raulhorgos/Automotive-electronics-system-project/Driver.png

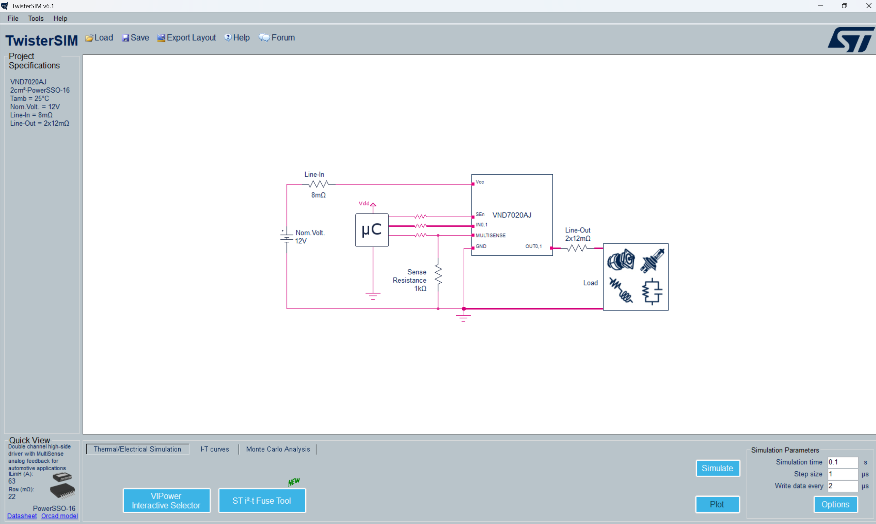
Driver.png
