raulhorgos/Automotive-electronics-system-project/LTSpice simulations/fast_transient.png

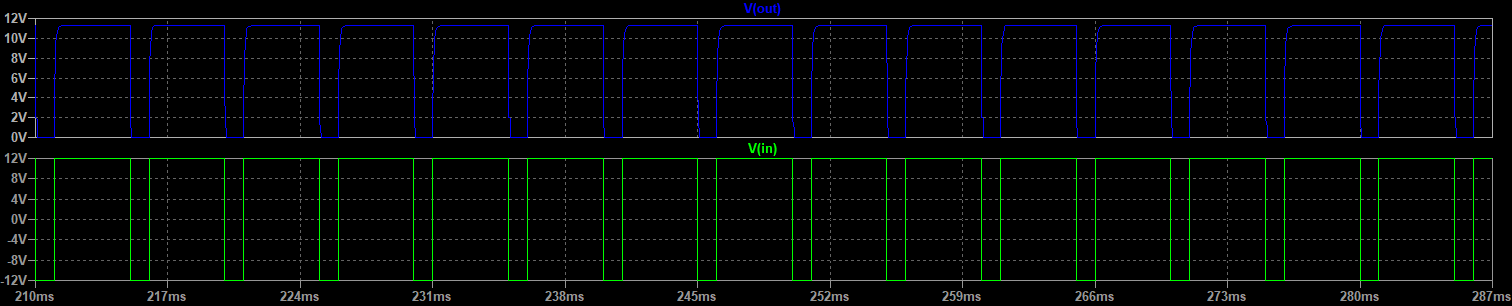
LTSpice simulations/fast_transient.png
