raulhorgos/Automotive-electronics-system-project/LTSpice simulations/Protection circuit.PNG

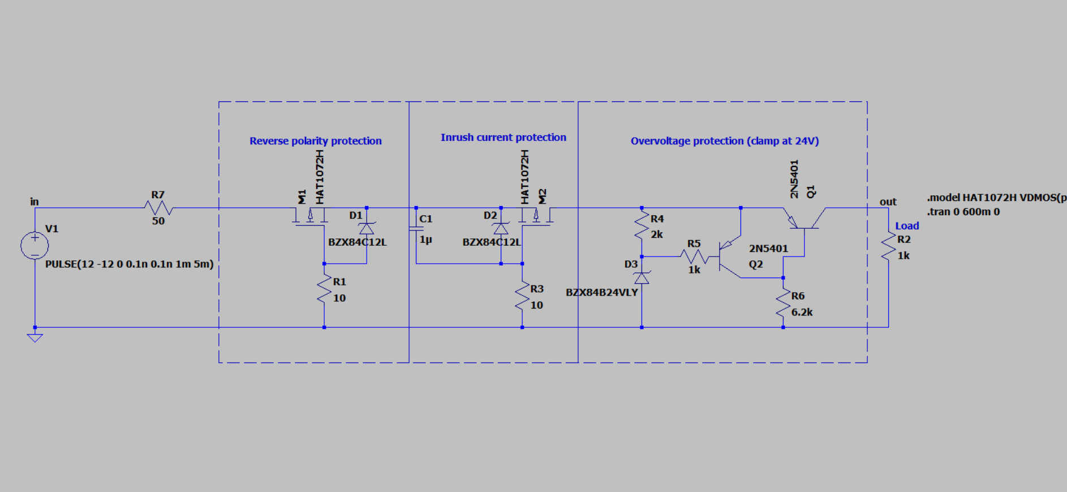
LTSpice simulations/Protection circuit.PNG
