raulhorgos/Automotive-electronics-system-project/Altium Files/Project Outputs for PCB_Project/BOM.PDF

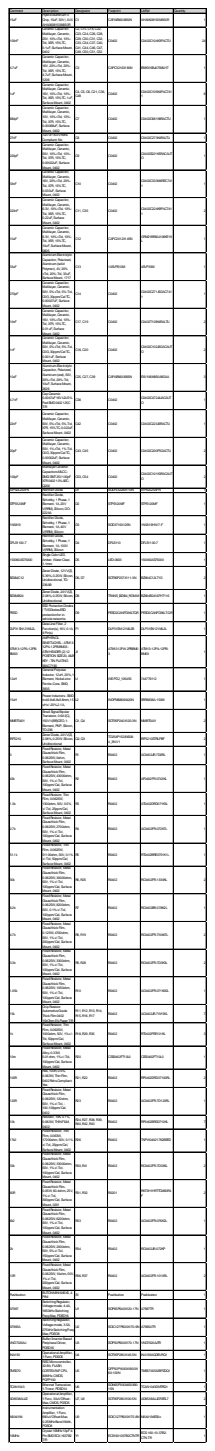
[picture p4: page 1]

100nF | Ceramic Capacitor, Multilayer, Ceramic, 25V, 10%+Tol, 10%-Tol, X5R, 15%TC, 0.1uF, SurfaceMount, 0402 | C2, C15, C16, C22, C23, C24, C26, C28, C29, C30, C31, C32, C33, C34, C37, C40, C41, C44, C46, C47, C49, C50, C51, C52 | C0402 | C0402C104K3PACTU | 24

4.7uF | Ceramic Capacitor, Multilayer, Ceramic, 16V, 20%+Tol, 20%-Tol, X5R, 15%TC, 4.7uF, SurfaceMount, 1206 | C3 | CAPC3216X180N | EMK316BJ475MLHT | 1

1uF | Ceramic Capacitor, Multilayer, Ceramic, 16V, 10%+Tol, 10%-Tol, X5R, 15%TC, 1uF, SurfaceMount, 0402 | C4, C5, C6, C21, C36, C48 | C0402 | C0402C105K4PAC741 1 | 6

680pF | Ceramic Capacitor, Multilayer, Ceramic, 10V, 10%+Tol, 10%-Tol, X7R, 15%TC, 0.00068uF, Surface Mount, 0402 | C7 | C0402 | C0402C681K8RACTU | 1

27nF | .027Uf 16.0VRohs Compliant: No | C8 | C0402 | C0402C273K4RALTU | 1

220pF | Ceramic Capacitor, Multilayer, Ceramic, 50V, 10%+Tol, 10%-Tol, X7R, 15%TC, 0.00022uF, Surface Mount, 0402 | C9 | C0402 | C0402S221K5RACAUT O | 1

33nF | Ceramic Capacitor, Multilayer, Ceramic, 16V, 20%+Tol, 20%-Tol, X7R, 15%TC, 0.033uF, Surface Mount, 0402 | C10 | C0402 | C0402C333M4REC741 1 | 1

220nF | Ceramic Capacitor, Multilayer, Ceramic, 6.3V, 10%+Tol, 10%-Tol, X5R, 15%TC, 0.22uF, Surface Mount, 0402 | C11, C35 | C0402 | C0402C224K9PAC741 1 | 2

10uF | Ceramic Capacitor, Multilayer, Ceramic, 6.3V, 10%+Tol, 10%-Tol, X5R, 15%TC, 10uF, SurfaceMount, 0805 | C12 | CAPC2012X145N | GRM21BR60J106KE19 L | 1

33uF | AluminumElectrolytic Capacitor, Polarized, Aluminum(solid Polymer), 4V, 20% +Tol, 20%-Tol, 33uF, SurfaceMount, 1717 | C13 | 10SVPS10M | 4SVP33M | 1

270pF | Ceramic Capacitor, Multilayer, Ceramic, 50V, 5%+Tol, 5%-Tol, C0G, 30ppm/Cel TC, 0.00027uF, Surface Mount, 0402 | C14 | C0402 | C0402C271J5GAC741 1 | 1

10nF | Ceramic Capacitor, Multilayer, Ceramic, 16V, 10%+Tol, 10%-Tol, X7R, 15%TC, 0.01uF, Surface Mount, 0402 | C17, C19 | C0402 | C0402T103K4RALTU | 2

1nF | Ceramic Capacitor, Multilayer, Ceramic, 50V, 5%+Tol, 5%-Tol, C0G, 30ppm/Cel TC, 0.001uF, Surface Mount, 0402 | C18, C20 | C0402 | C0402C102J5GACAUT O | 2

10uF | AluminumElectrolytic Capacitor, Polarized, Aluminum(wet), 50V, 20%+Tol, 20%-Tol, 10uF, SurfaceMount, 2626 | C25, C27, C39 | CAPAE660X565N | EXV106M050A9GAA | 3

4.7nF | CapCeramic 0.0047uF16VU2J5% PadSMD0402125C T/R | C38 | C0402 | C0402C472J4JACAUT O | 1

22nF | Ceramic Capacitor, Multilayer, Ceramic, 50V, 5%+Tol, 5%-Tol, X7R, 15%TC, 0.022uF, SurfaceMount, 0402 | C42 | C0402 | C0402C223J5RACTU | 1

20pF | Ceramic Capacitor, Multilayer, Ceramic, 50V, 1%+Tol, 1%-Tol, C0G, 30ppm/Cel TC, 0.00002uF, Surface Mount, 0402 | C43, C45 | C0402 | C0402C200F5GACTU | 2

100pF | Multilayer Ceramic Capacitors MLCC-SMD/SMT25V100pF X7R040210%AEC-Q200 | C53, C54 | C0402 | C0402C101K3RACAUT O | 2

STPS2L25AFN STPS120MF | Rectifier Diode, Rectifier Diode Schottky, 1Phase, 1 Element, 1A, 20V V(RRM), Silicon, DO-222AA | D1 D2 | SODFL5226X110N STPS120MF | STPS2L25AFN STPS120MF | 1 1

1N5819 | Rectifier Diode, Schottky, 1Phase, 1 Element, 1A, 40V V(RRM), Silicon | D3 | SOD3716X125N | 1N5819HW-7-F | 1

DFLS1100-7 | Rectifier Diode, Schottky, 1Phase, 1 Element, 1A, 100V V(RRM), Silicon | D4 | DFLS110 | DFLS1100-7 | 1

150060AS75000 | SingleColor LED, Amber, Water Clear, 1.1mm | D5 | LED-0603 | 150060AS75000 | 1

BZX84C12 | Zener Diode, 12VV(Z), 5.39%, 0.25W, Silicon, Unidirectional, TO-236AB | D6, D7 | SOT96P237X111-3N | BZX84C12LT1G | 2

BZX84B24 | Zener Diode, 24VV(Z), 2.08%, 0.25W, Silicon, Unidirectional | D8 | TRANS_BZX84_ROM-M | BZX84B24VLFHT116 | 1

PESD | / TVSDiodesESD ESDProtectionDiodes protectionfor in-vehicle networks | D9 | PESD2CANFD36LTQR | PESD2CANFD36LT-QR | 1

DLP31SN121ML2L | DataLineFilter, 2 Function(s), 16V, 0.1A, 4Pin(s) | F1 | DLP31SN121ML2B | DLP31SN121ML2L | 1

ATM13-12PA-12PB-BM03 | AMPHENOL SINE/TUCHEL- ATM13-12PA-12PB-BM03-ATMHEADER (2)12 POSITIONSIZE20, A&B KEY- TINPLATING 98AC7190 | J1 | ATM1312PA12PBBM0 3 | ATM13-12PA-12PB-BM03 | 1

12uH | General Purpose Inductor, 12uH, 20%, 1 Element, Nickel-zinc Ferrite-Core, SMD, 3935 | L1 | WE-PD2_105455 | 744776112 | 1

15uH | Power Inductors - SMD Ind,6.8x6.8x3.8mm,15 uH+/-20%,2.1A, | L2 | INDPM6868X420N | SRR6838A-150M | 1

MMBT5401 | Small Signal Bipolar Transistor, 0.6AI(C), 150VV(BR)CEO, 1-Element, PNP, Silicon, TO-236 | Q1, Q4 | SOT95P240X120-3N | MMBT5401 | 2

IRF5210 | Zener Diode, 24VV(Z), 2.08%, 0.25W, Silicon, Unidirectional | Q2, Q3 | TO254P1528X508-4_3N-V1 | IRF5210STRLPBF | 2

0 | FixedResistor, Metal Glaze/thickFilm, 0.0625W, 0ohm, SurfaceMount, 0402 | R1 | R0402 | AC0402JR-7D0RL | 1

43k | FixedResistor, Metal Glaze/thickFilm, 0.0625W, 43000ohm, 50V, 1%+/-Tol, 100ppm/Cel, Surface Mount, 0402 | R2 | R0402 | AF0402FR-0743KL | 1

1.3k | FixedResistor, Thin Film, 0.0625W, 1300ohm, 50V, 0.5% +/-Tol, 25ppm/Cel, SurfaceMount, 0402 | R3 | R0402 | AT0402DRD071K3L | 1

2.7k | FixedResistor, Metal Glaze/thickFilm, 0.0625W, 2700ohm, 50V, 1%+/-Tol, 100ppm/Cel, Surface Mount, 0402 | R4 | R0402 | AC0402FR-072K7L | 1

51.1k | FixedResistor, Thin Film, 0.0625W, 51100ohm, 50V, 0.1% +/-Tol, 50ppm/Cel, SurfaceMount, 0402 | R5 | R0402 | RT0402BRE0751K1L | 1

30k | FixedResistor, Metal Glaze/thickFilm, 0.0625W, 30000ohm, 50V, 1%+/-Tol, 100ppm/Cel, Surface Mount, 0402 | R6, R25 | R0402 | RC0402FR-1330KL | 2

8.2k | FixedResistor, Metal Glaze/thickFilm, 0.0625W, 8200ohm, 50V, 0.1%+/-Tol, 100ppm/Cel, Surface Mount, 0402 | R7 | R0402 | RC0402BR-078K2L | 1

4.7k | FixedResistor, Metal Glaze/thickFilm, 0.125W, 4700ohm, 50V, 1%+/-Tol, 200ppm/Cel, Surface Mount, 0402 | R8, R19 | R0402 | RC0402FR-7W4K7L | 2

3.3k | FixedResistor, Metal Glaze/thickFilm, 0.0625W, 3300ohm, 50V, 1%+/-Tol, 100ppm/Cel, Surface Mount, 0402 | R9, R28 | R0402 | RC0402FR-7D3K3L | 2

1.05k | FixedResistor, Metal Glaze/thickFilm, 0.0625W, 1050ohm, 50V, 1%+/-Tol, 100ppm/Cel, Surface Mount, 0402 | R10 | R0402 | AC0402FR-071K05L | 1

15k | ChipResistor AutomotiveGrade ThickFilm 0402 15kOhm5%Paper T/R | R11, R12, R13, R14, R15, R16, R17 | R0402 | AC0402JR-7W15KL | 7

1k | FixedResistor, Thin Film, 0.0625W, 1000ohm, 50V, 1%+/-Tol, 50ppm/Cel, SurfaceMount, 0402 | R18, R29, R35 | R0402 | RT0402FRE101KL | 3

10m | FixedResistor, Metal Alloy, 0.33W, 0.01ohm, 1%+/-Tol, 100ppm/Cel, Surface Mount, 0402 | R20 | CSS0402FT10L0 | CSS0402FT10L0 | 1

100R | Res, 100R, 0.5%, 0.063W, ThinFilm, 0402RohsCompliant: Yes | R21, R22 | R0402 | RP0402DRD07100RL | 2

120R | FixedResistor, Metal Glaze/thickFilm, 0.0625W, 120ohm, 50V, 1%+/-Tol, -100,100ppm/Cel, 0402 | R23 | R0402 | AC0402FR-7D120RL | 1

10k | Resistor, 10K, 0.1%, 0.063W, THINFILM, 0402; | R24, R27, R38, R39, R40, R42, R43 | R0402 | RP0402BRD0710KL | 7

17k2 | FixedResistor, Thin Film, 0.063W, 17200ohm, 50V, 0.1% +/-Tol, 25ppm/Cel, SurfaceMount, 0402 | R26 | R0402 | TNPW040217K2BEED | 1

33k | FixedResistor, Metal Glaze/thickFilm, 0.0625W, 33000ohm, 50V, 1%+/-Tol, 100ppm/Cel, Surface Mount, 0402 | R30, R41 | R0402 | RC0402FR-7D33KL | 2

60R | FixedResistor, Metal Glaze/thickFilm, 0.05W, 60.4ohm, 25V, 1%+/-Tol, 300ppm/Cel, Surface Mount, 0201 | R31, R32 | R0201 | RK73H1HRTTCM60R4 F | 2

6k2 | FixedResistor, Metal Glaze/thickFilm, 0.0625W, 6200ohm, 50V, 1%+/-Tol, 100ppm/Cel, Surface Mount, 0402 | R33 | R0402 | AC0402FR-076K2L | 1

2k | FixedResistor, Metal Glaze/thickFilm, 0.0625W, 2000ohm, 50V, 5%+/-Tol, 150ppm/Cel, Surface Mount, 0402 | R34 | R0402 | RC0402JR-072KP | 1

10R | FixedResistor, Metal Glaze/thickFilm, 0.0625W, 10ohm, 50V, 1%+/-Tol, 200ppm/Cel, Surface Mount, 0402 | R36, R37 | R0402 | AC0402FR-1010RL | 2

Pushbutton | BUTONMINI6X6X5, 4 PINI | S1 | Pushbutton | Pushbutton | 1

A7987 | SwitchingRegulator, Voltage-mode, 4.4A, 1650kHzSwitching Freq-Max, PDSO16 | U1 | SOP65P640X120-17N | A7987TR | 1

A7985A | SwitchingRegulator, Voltage-mode, 3.5A, 275kHzSwitchingFreq-Max, PDSO8 | U2 | SOIC127P600X170-9N | A7985ATR | 1

VND7020AJ | Buffer/Inverter Based Peripheral Driver, PDSO16 | U3 | SOP50P600X170-17N | VND7020AJTR | 1

INA193 | Operational Amplifier, 1Func, PDSO5 | U4 | SOT95P280X145-5N | INA193AQDBVRQ1 | 1

TMS570 | RISCMicrocontroller, 32-Bit, FLASH, CORTEX-R4FCPU, 80MHz, CMOS, PQFP100 | U5 | QFP50P1600X1600X1 60-100N | TMS5700332BPZQQ1 | 1

TCAN1043 | Ethernet Transceiver, 1-Trnsvr, PDSO14 | U6 | SON65P300X450X90-15N | TCAN1043DMTRQ1 | 1

AD8538AUJZ | Operational Amplifier, 1Func, 30uVOffset-Max, CMOS, PDSO5 | U7, U8 | SOT95P280X100-5N | AD8538AUJZ-REEL7 | 2

MAX4194 | Instrumentation Amplifier, 1Func, 690uVOffset-Max, 0.25MHzBandWidth, PDSO8 | U9 | SOIC127P600X175-8N | MAX4194ESA+ | 1

16MHz | Crystal 16MHz10pF4-PinSMDECX-1637B2 T/R | Y1 | ECS1601037B2CTNTR | ECS-160-10-37B2-CTN-TR | 1
