raulhorgos/Automotive-electronics-system-project/LTSpice simulations/Reverse polarity results.PNG

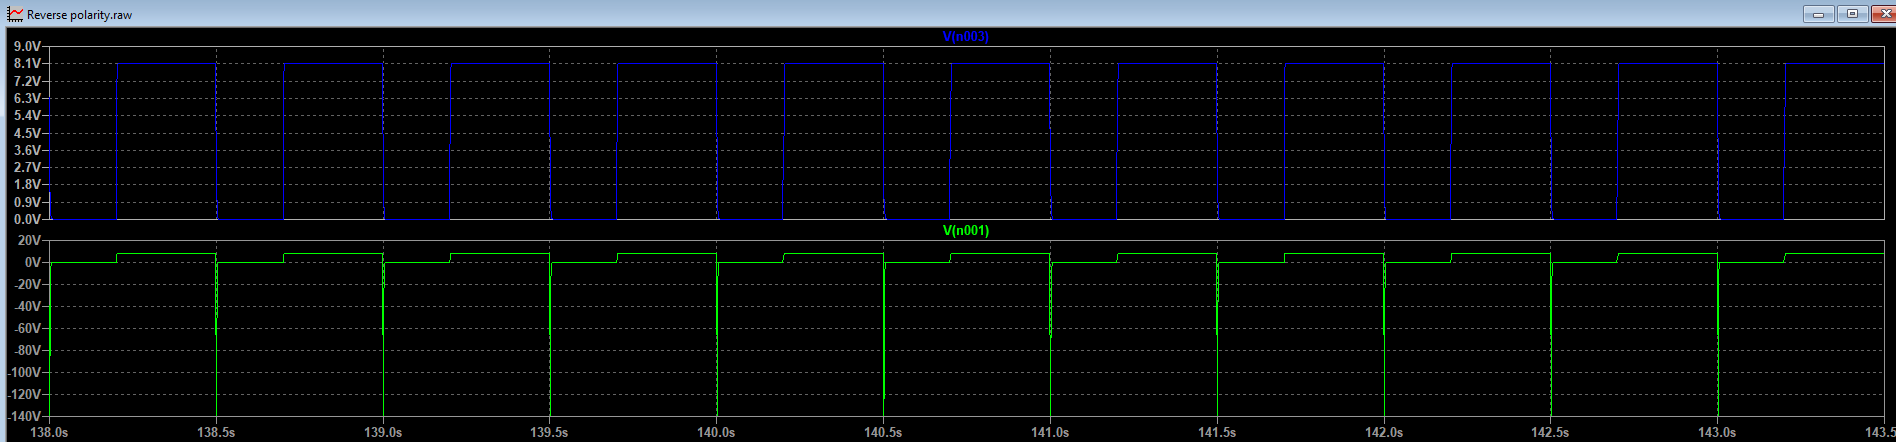
LTSpice simulations/Reverse polarity results.PNG
