raulhorgos/Automotive-electronics-system-project/Shunt measurement TinaTI.PDF

# Linearity_INA_LM

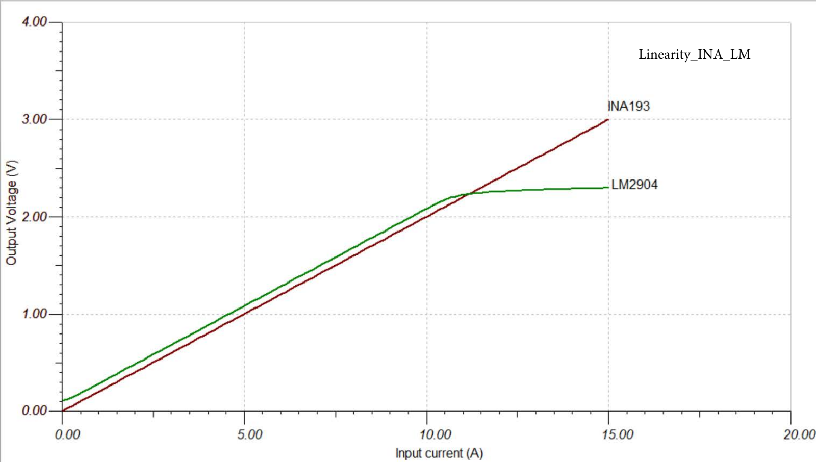
[picture p6: page 1]

# Shunt Tina TI

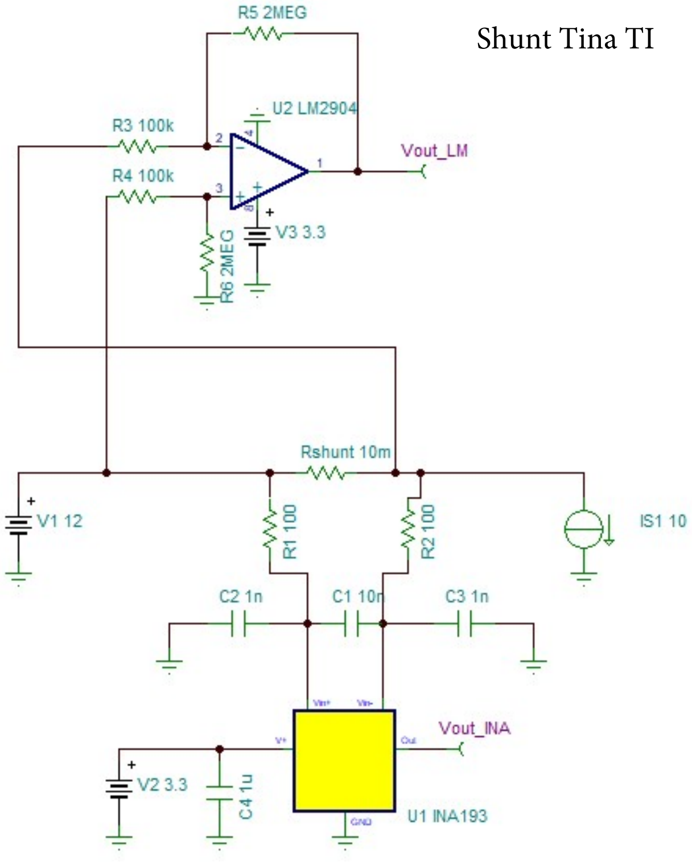
[picture p7: page 2]

# Temp_10A

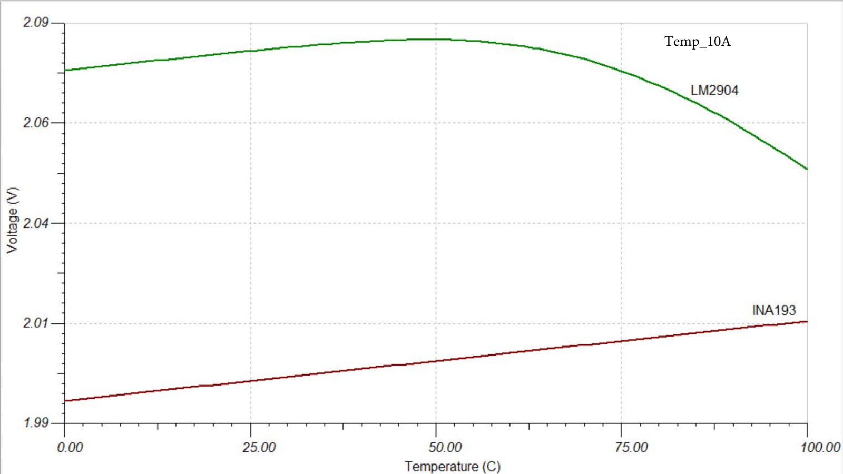
[picture p8: page 3]
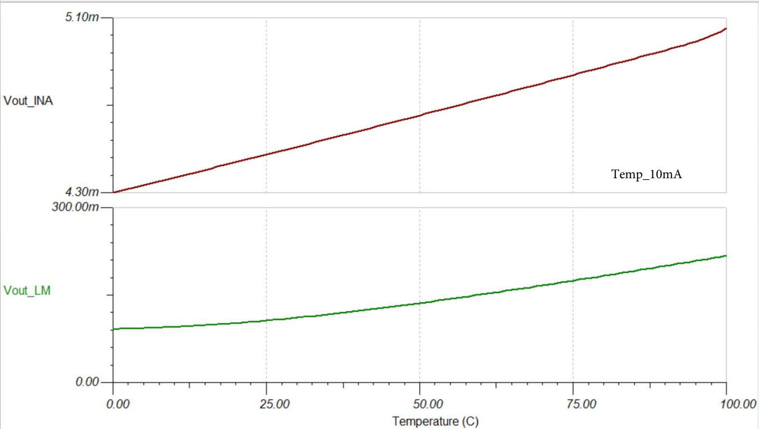
[picture p9: page 4]

# Temp_10mA

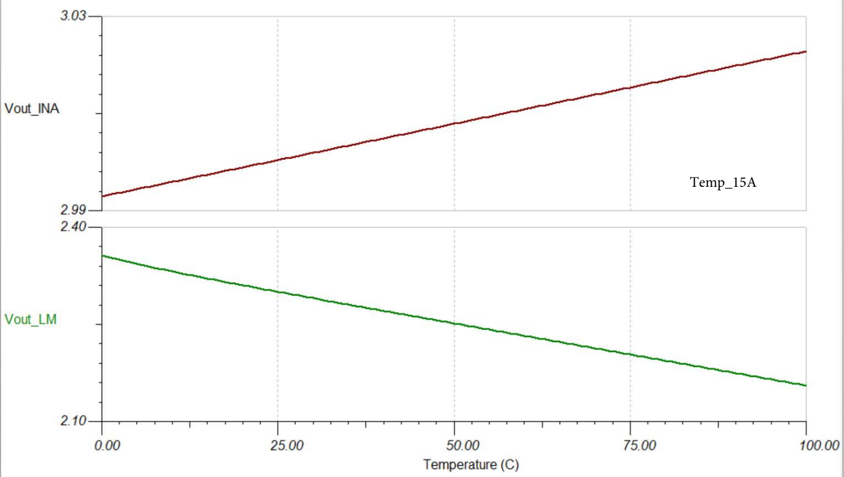
[picture p10: page 5]

# Temp_15A

# Tolerance_INA193

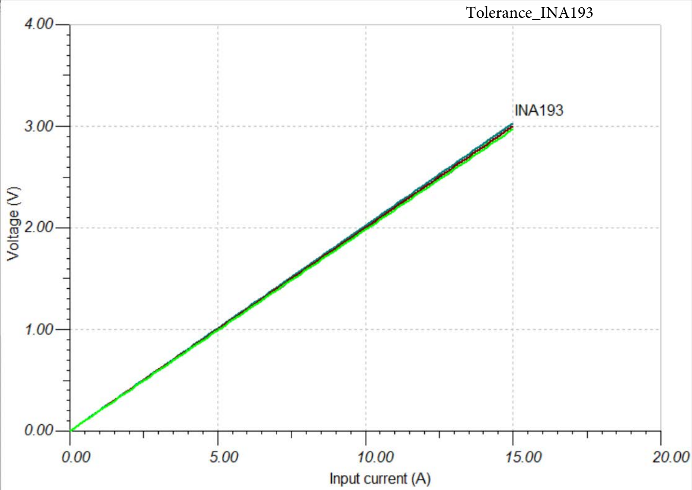
[picture p11: page 6]
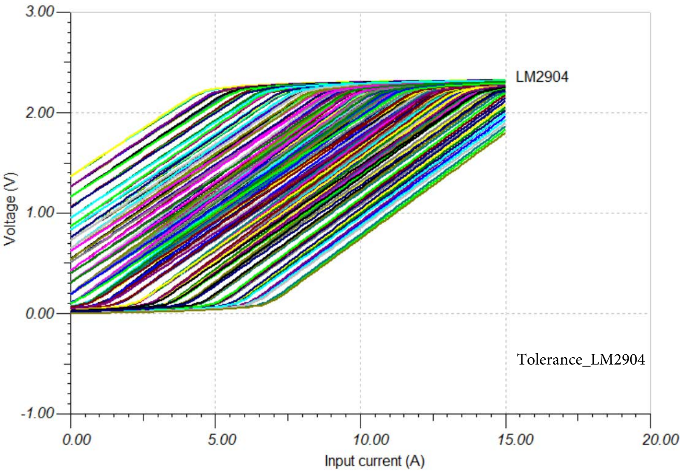
[picture p12: page 7]

# Tolerance_LM2904

1 | 1

# Drill Drawing View (Scale 1:1)

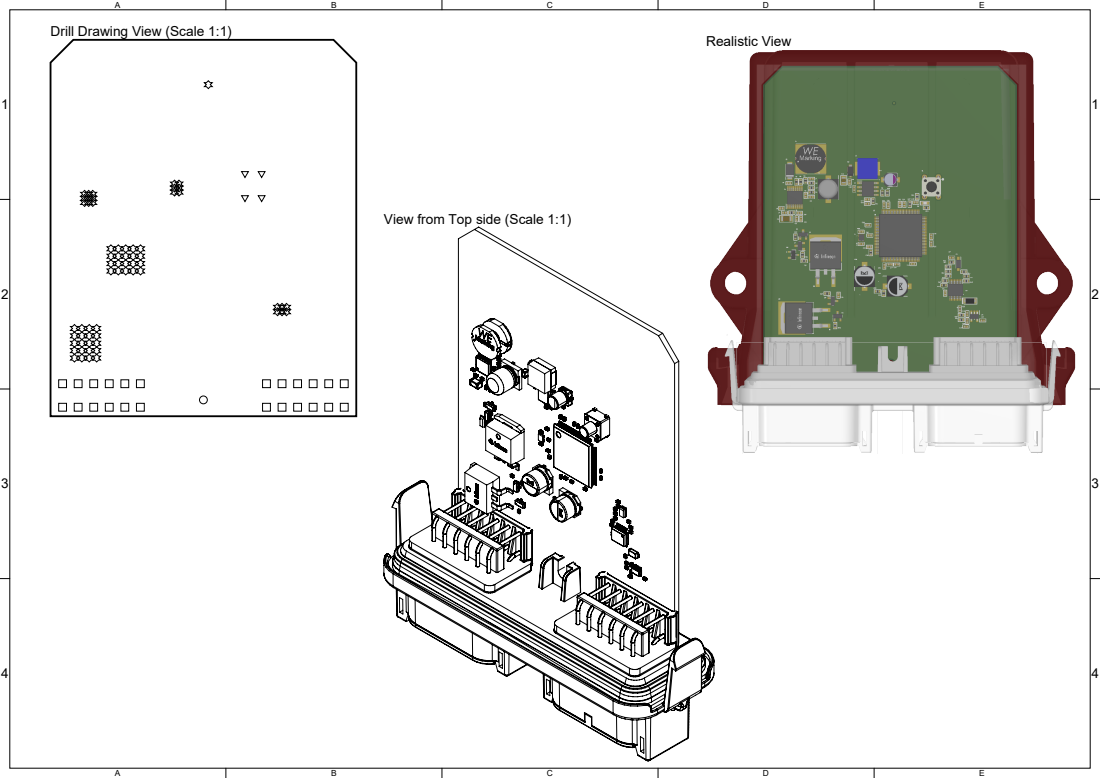
[picture p13: page 8]
Realistic View

View from Top side (Scale 1:1)

1 | 1

L1

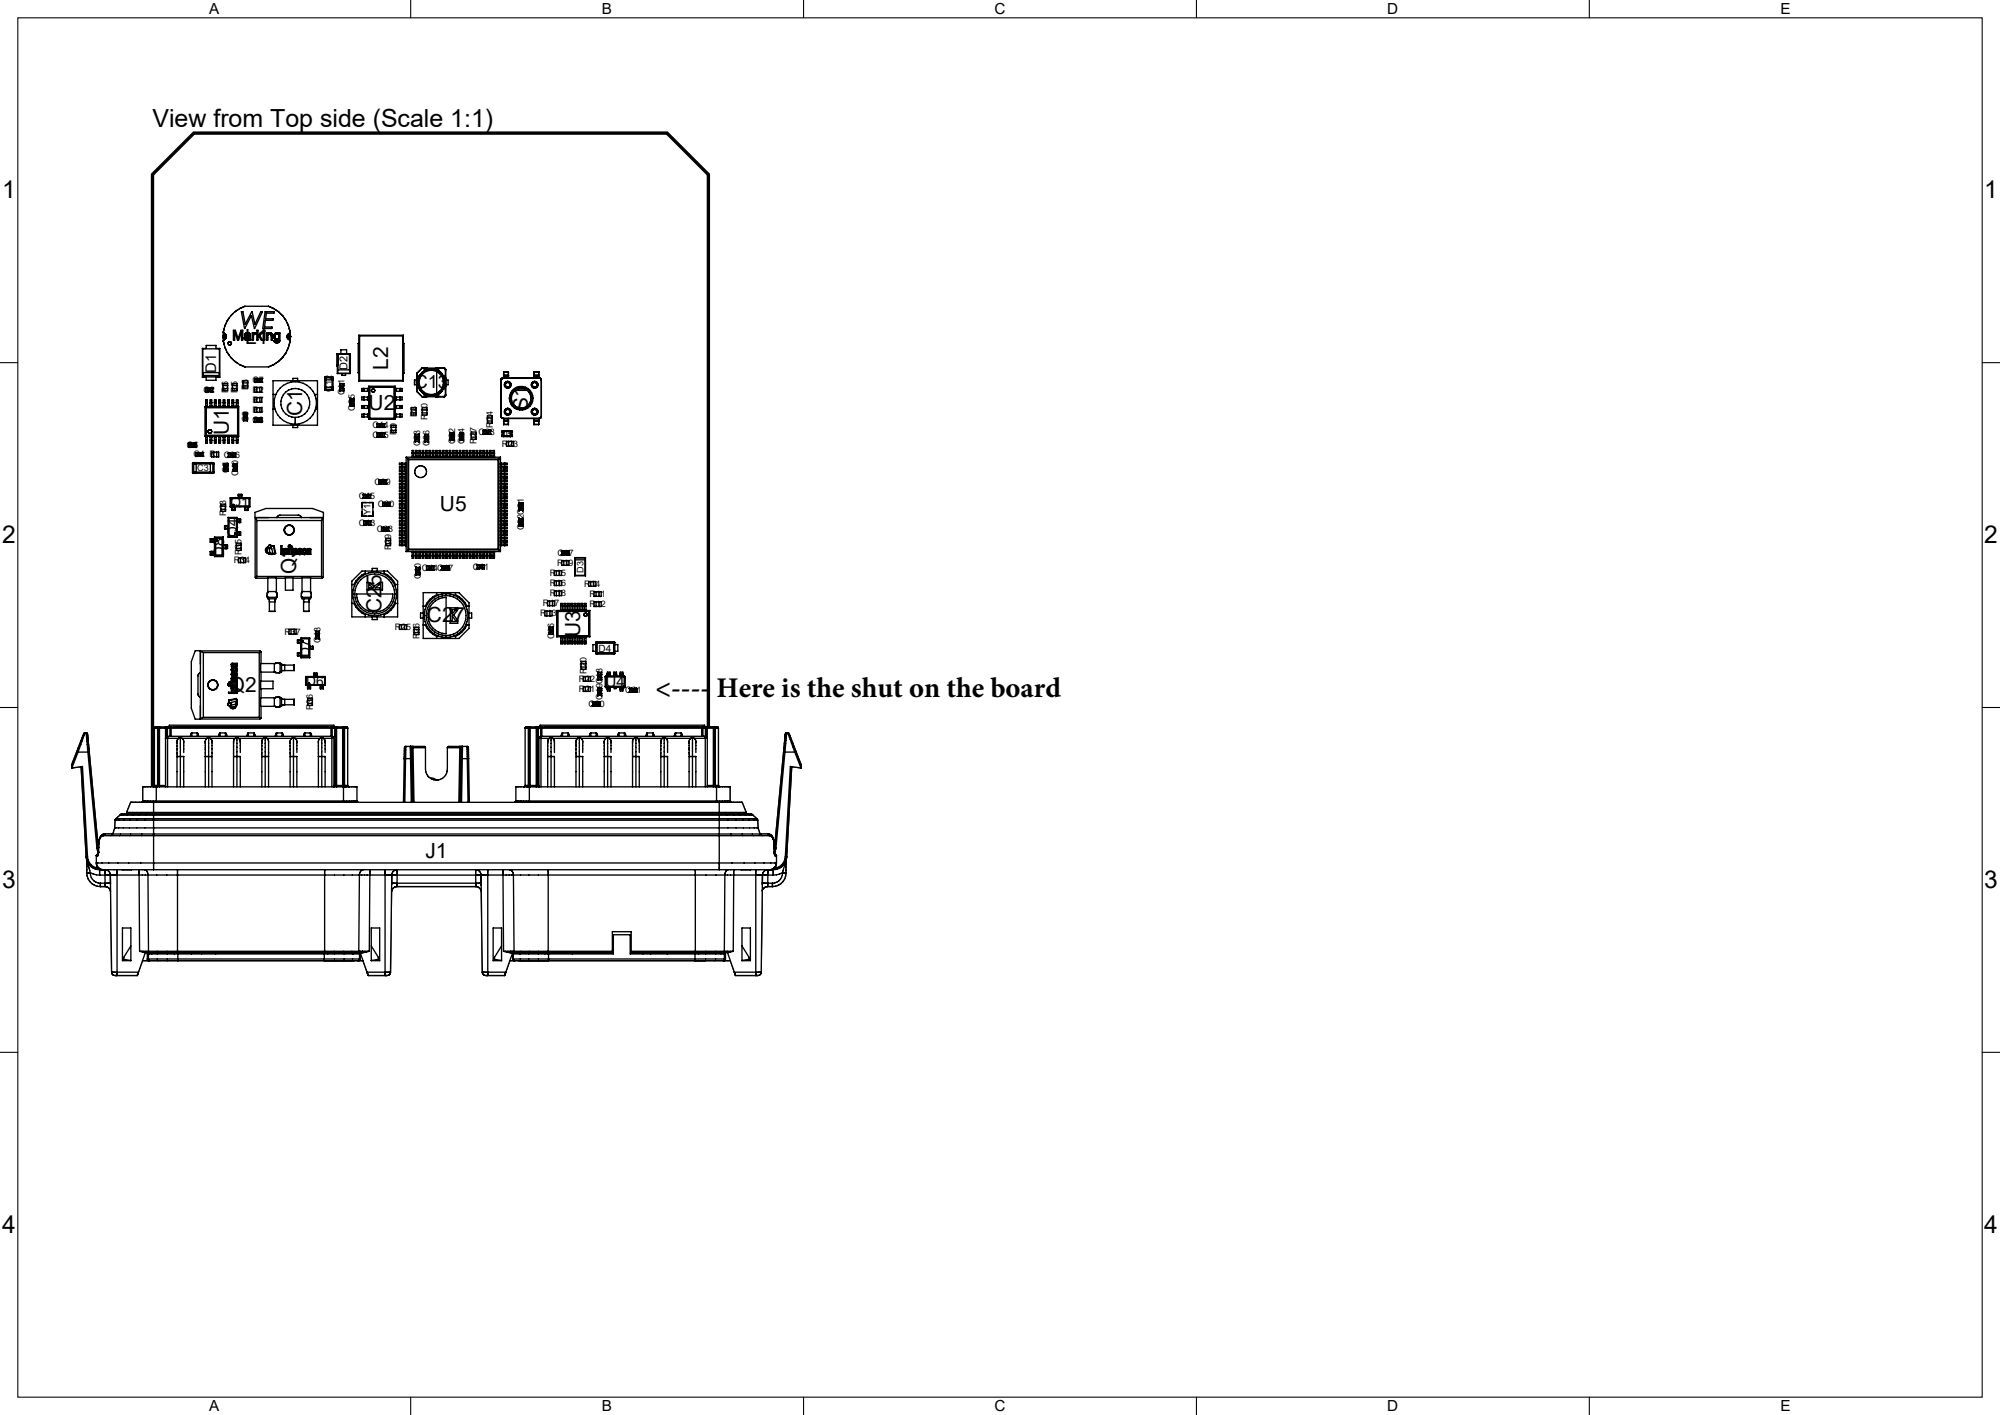
[picture p14: page 9]

View from Top side (Scale 1:1)

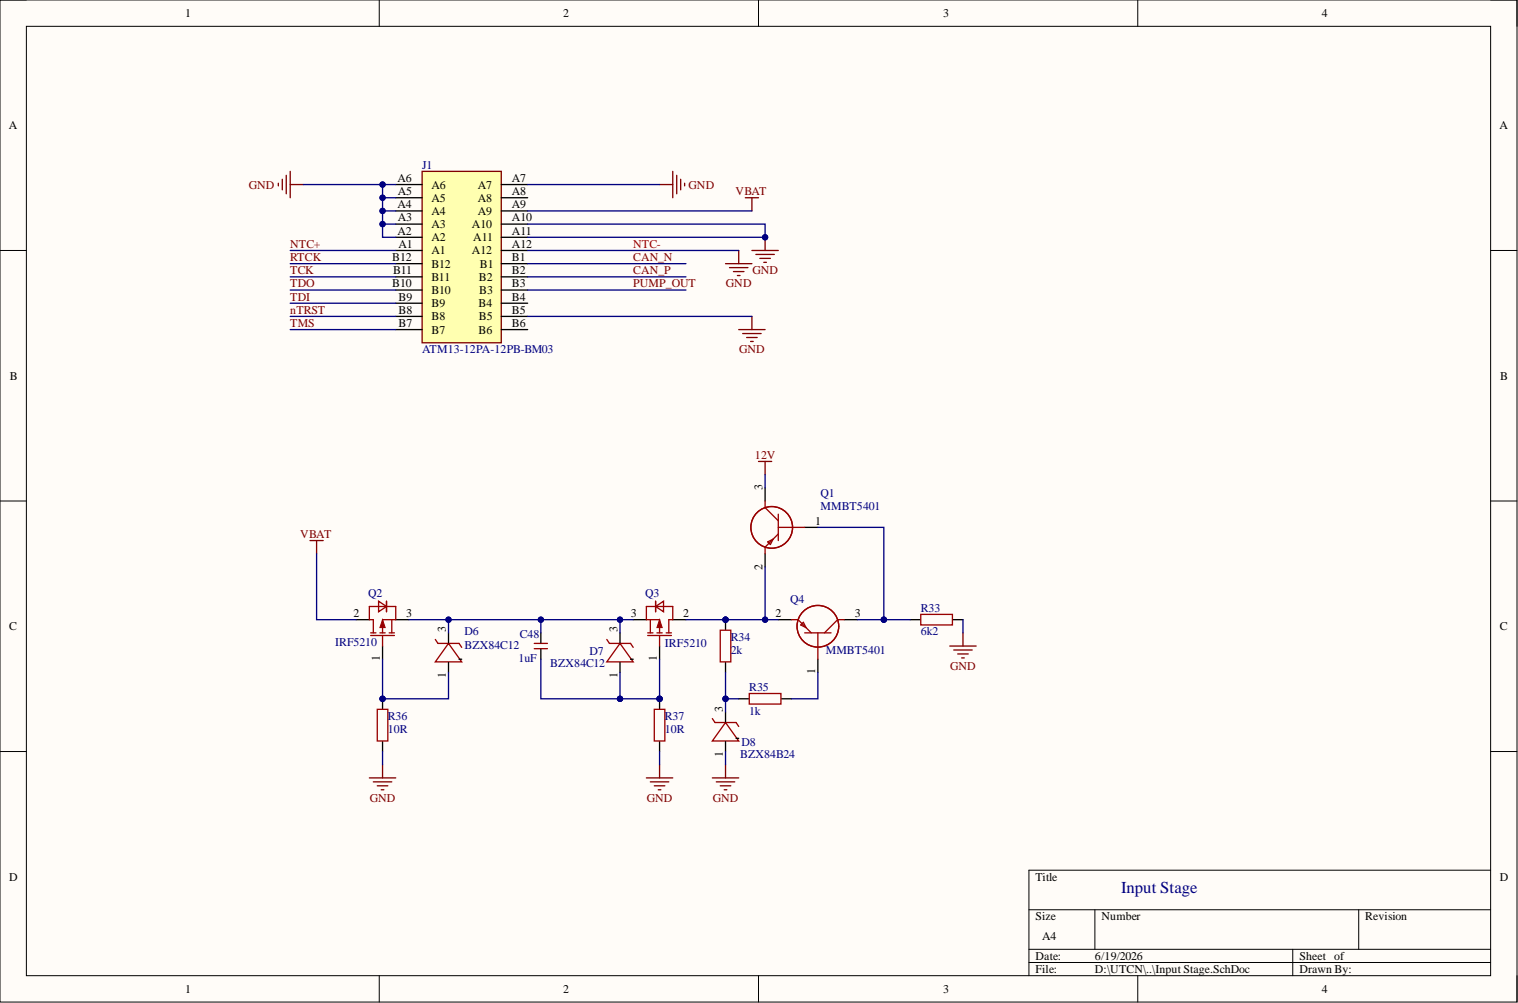
[picture p15: page 10]

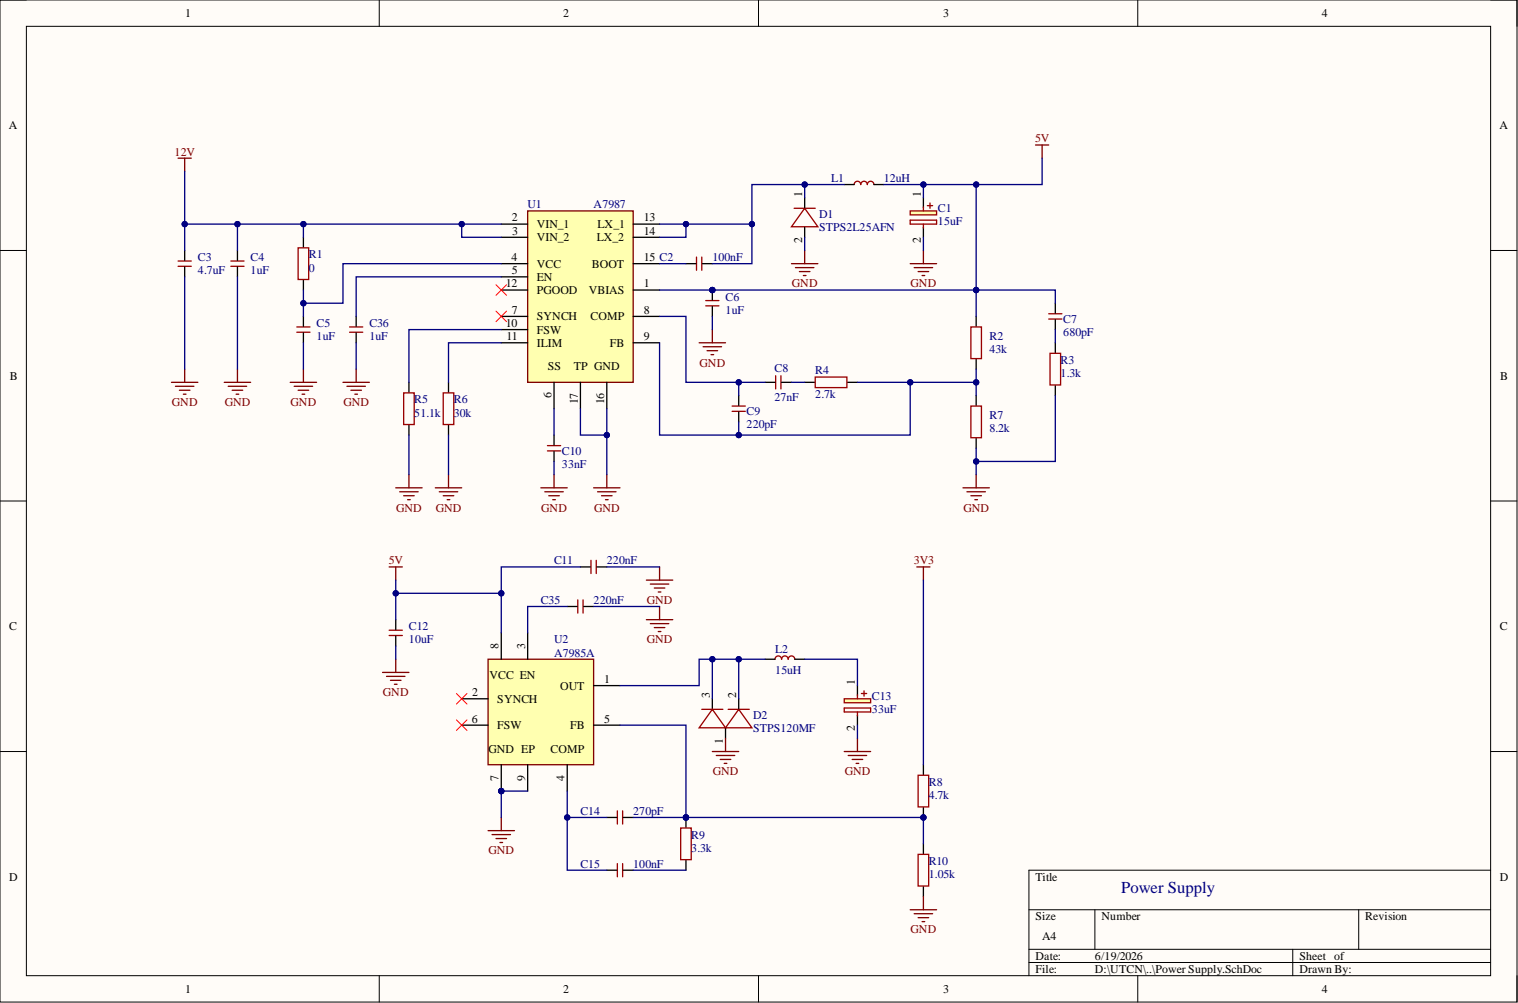
[picture p16: page 11]

## S1 GN

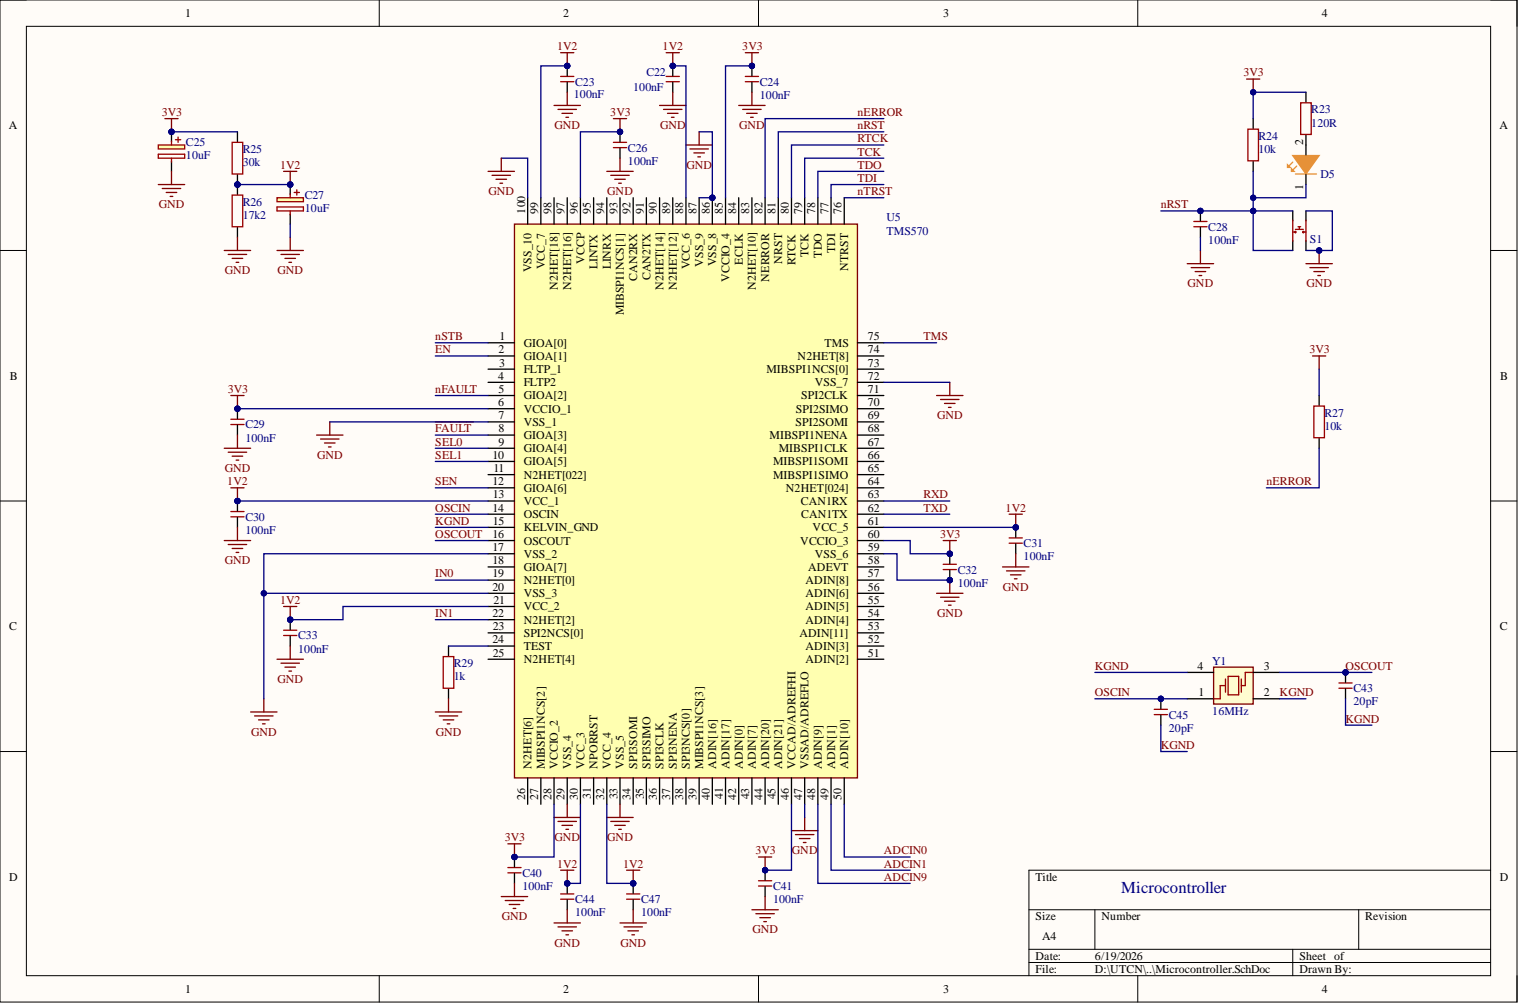
[picture p17: page 12]
Size; umb; Rev; Dat; Sheet; TCN; \..\Microco; tro; ler; Draw; GIO; FLTP_; FLT; VCCIO; VSS_; VCC_; OSCI; LVIN; OSCO; SPI2; NCS[0; N2HET[6] 26; MIBSPI1NCS[2] 27; VSS; VCC; NPORRST 31; SPI3SOMI 34 SPI3SIMO 35 SPI3CLK 36; SPI3NENA 37; SPI3NCS[0] 38; MIBSPI1NCS[3] 39; ADIN[16] 40; ADIN[17] 41 ADIN[0] 42; ADIN[7] 43; ADIN[20] 44; ADIN[21] 45; VCCAD/ADREFHI 46 VSSAD/ADREFLO 47; ADIN[9] 48; ADIN[1] 49; ADIN[10] 50; TMS; MIBSPI1; SPI2CL; SPI2SIM; SPI2SO; MIBSPI1CL; MIBSPI1SOMI; MIBSPI1SIMO; DIN; DIN[1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

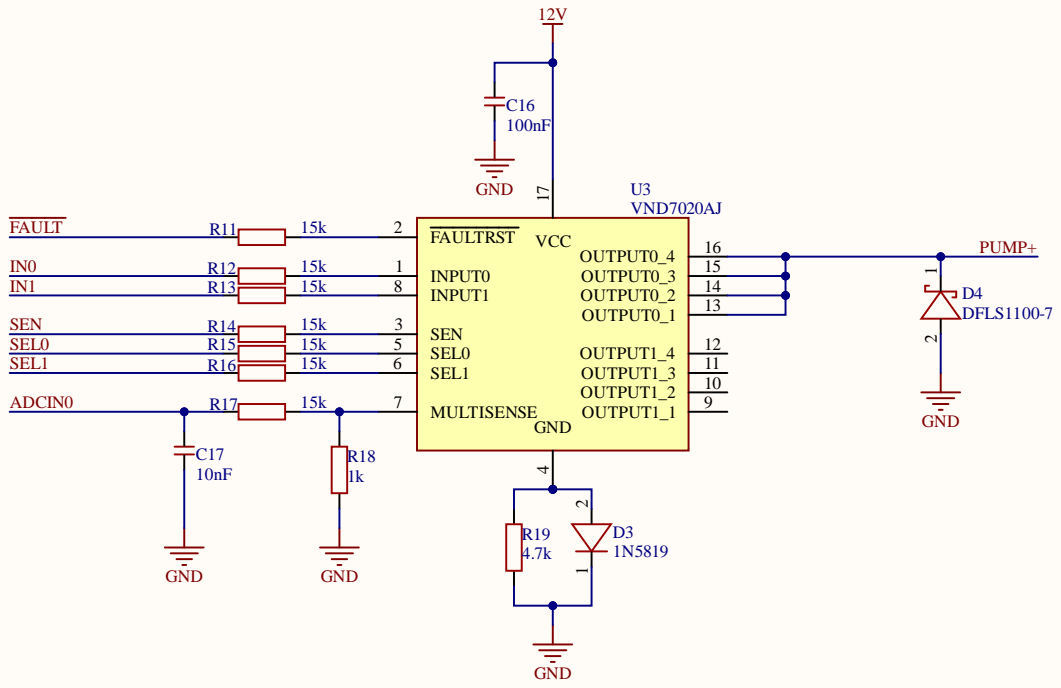
[picture p18: page 13]
Size; umb; Rev; Dat; Sheet; TCN; \..\Pump; Dri; ver.Sch; Draw; INPU; LTISE; VCC¹⁷; TPU; DCI; PUMP+; 4 DFLS1; Pump; Driver

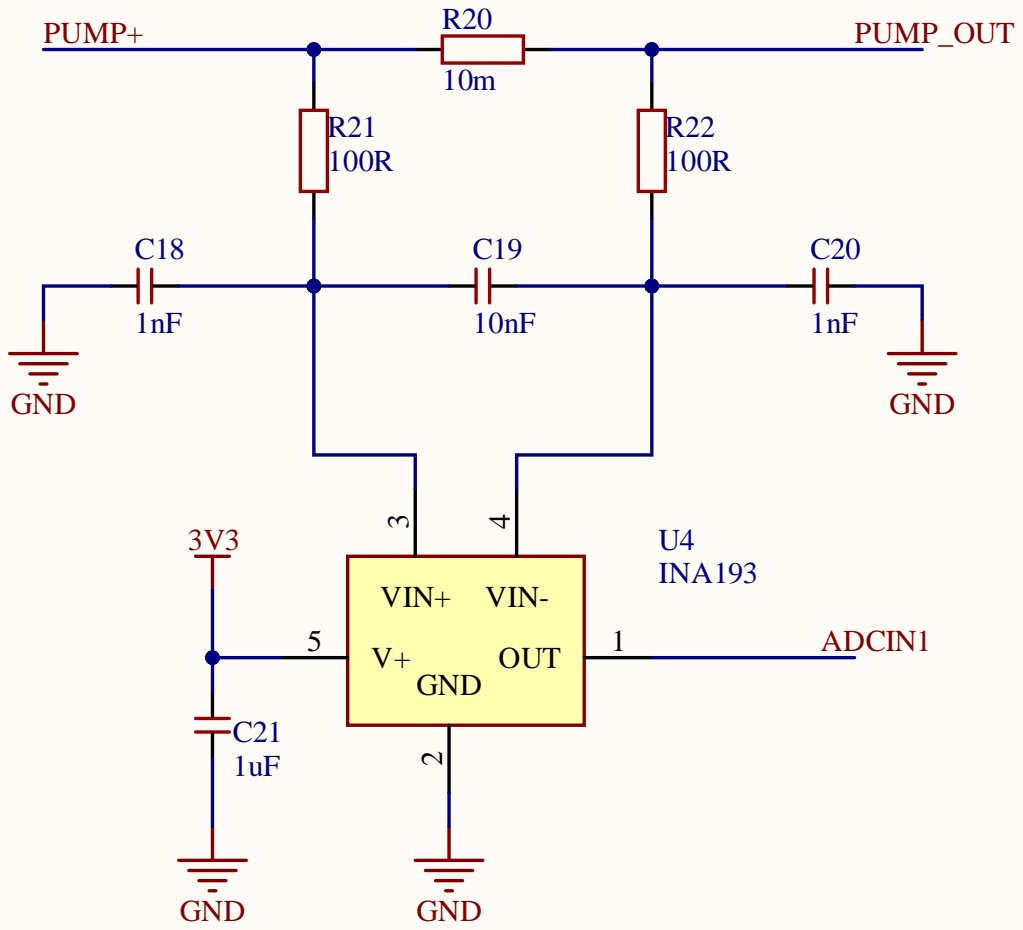
[picture p19: page 14]

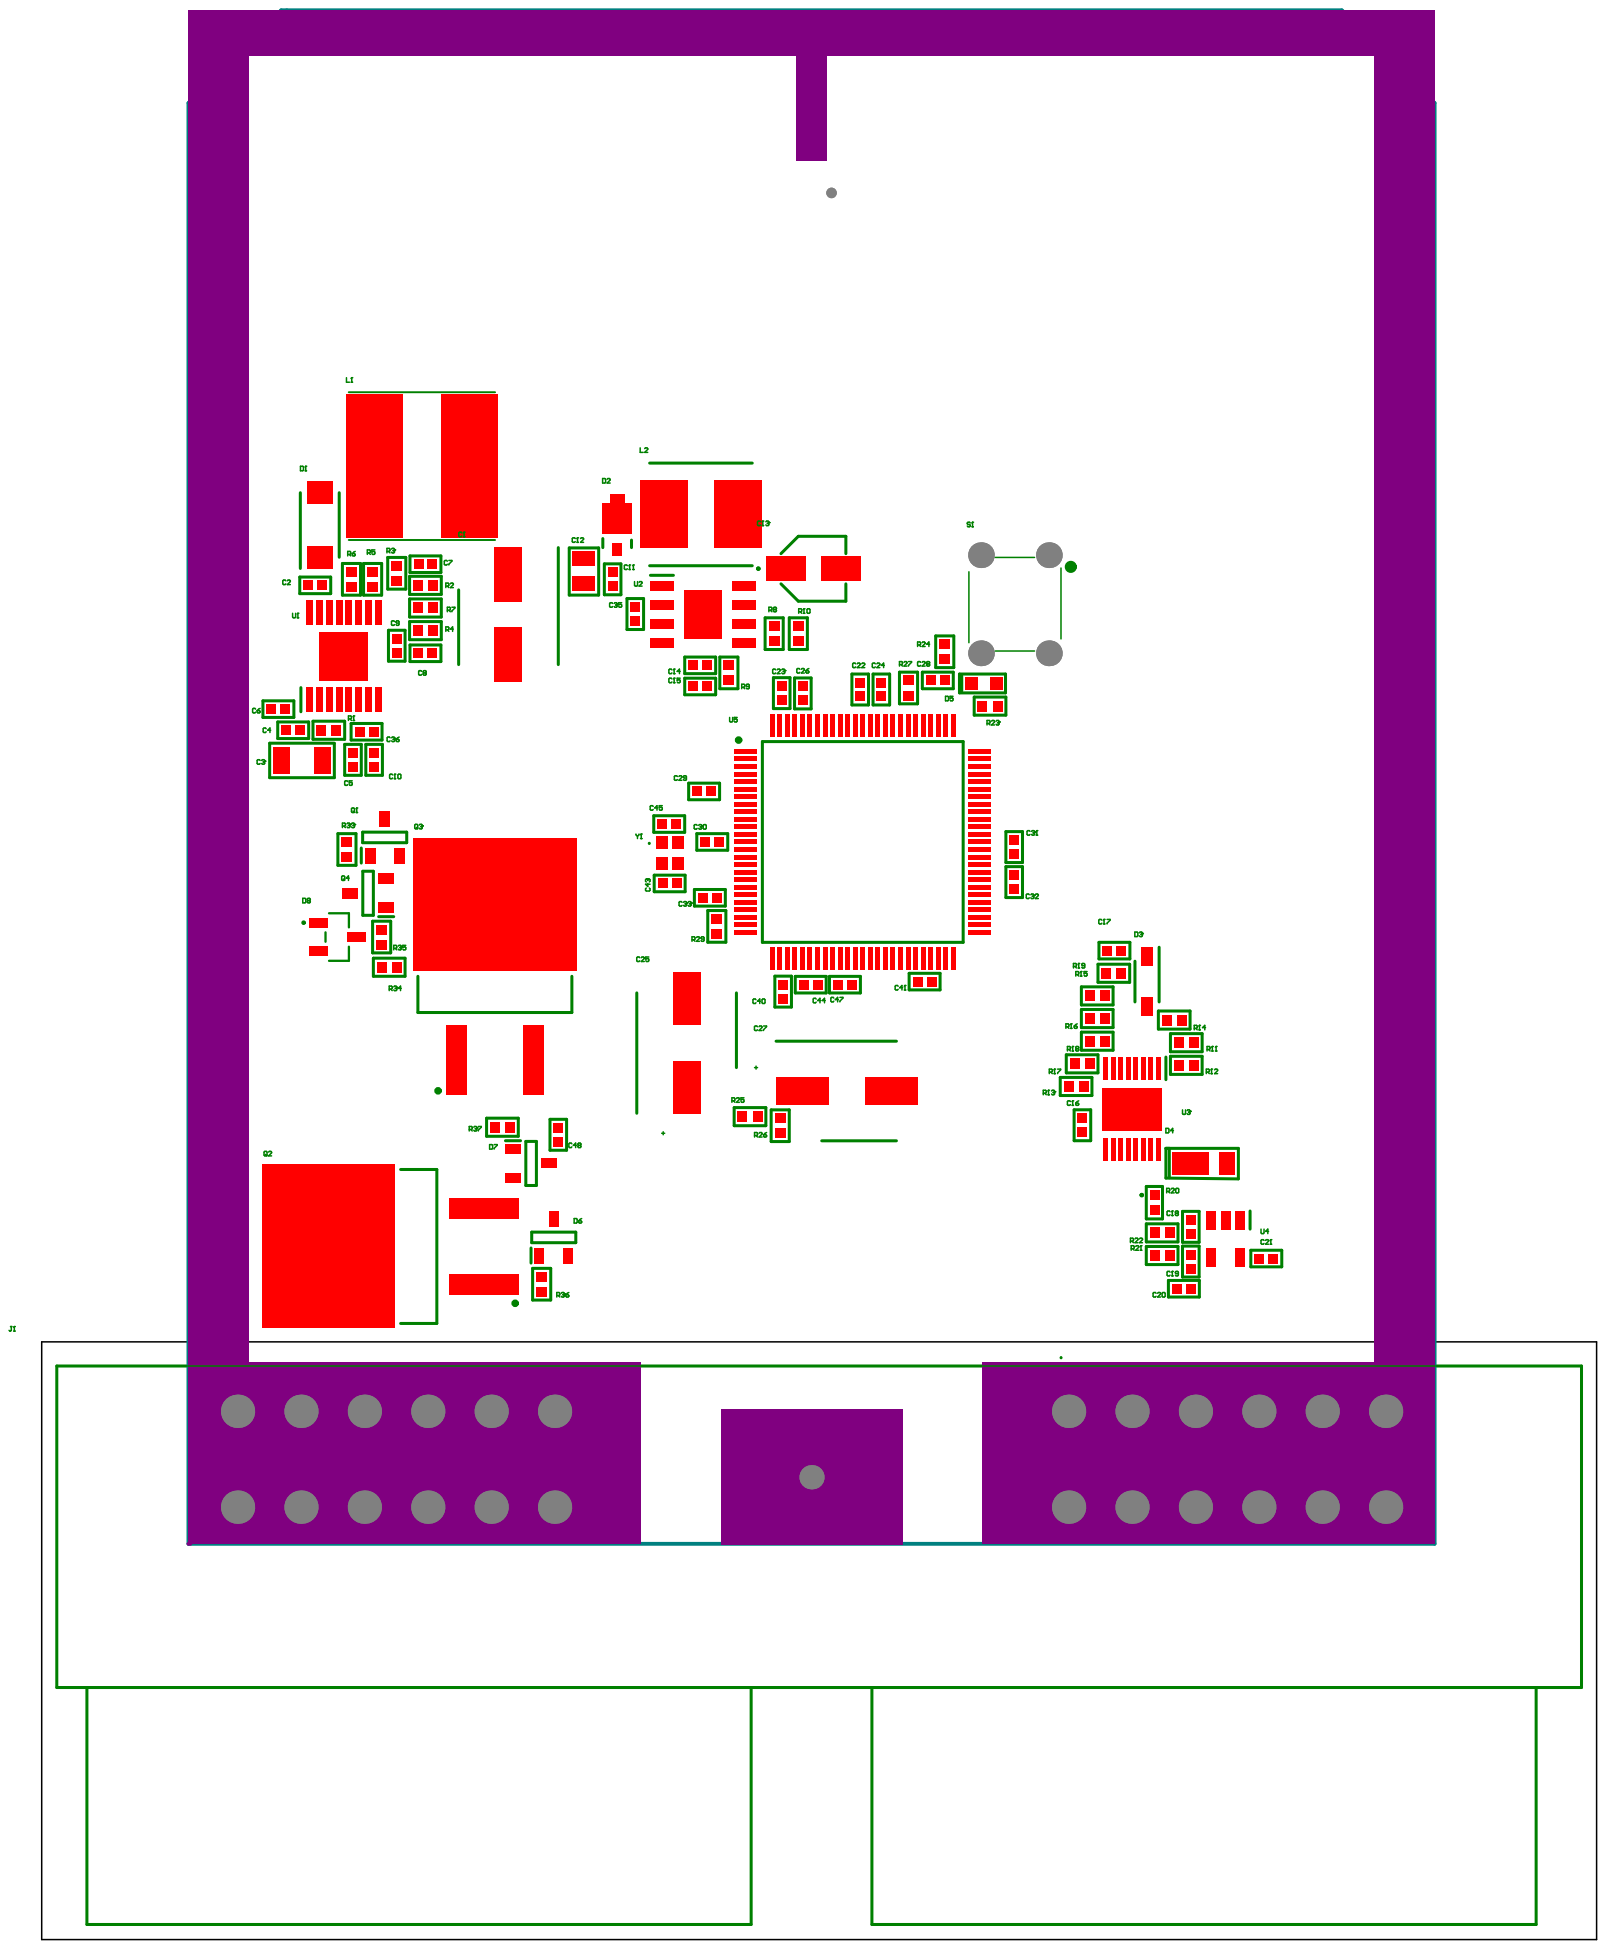
[picture p20: page 15]
