raulhorgos/Automotive-electronics-system-project/Altium Files/Project Outputs for PCB_Project/PCB.PDF

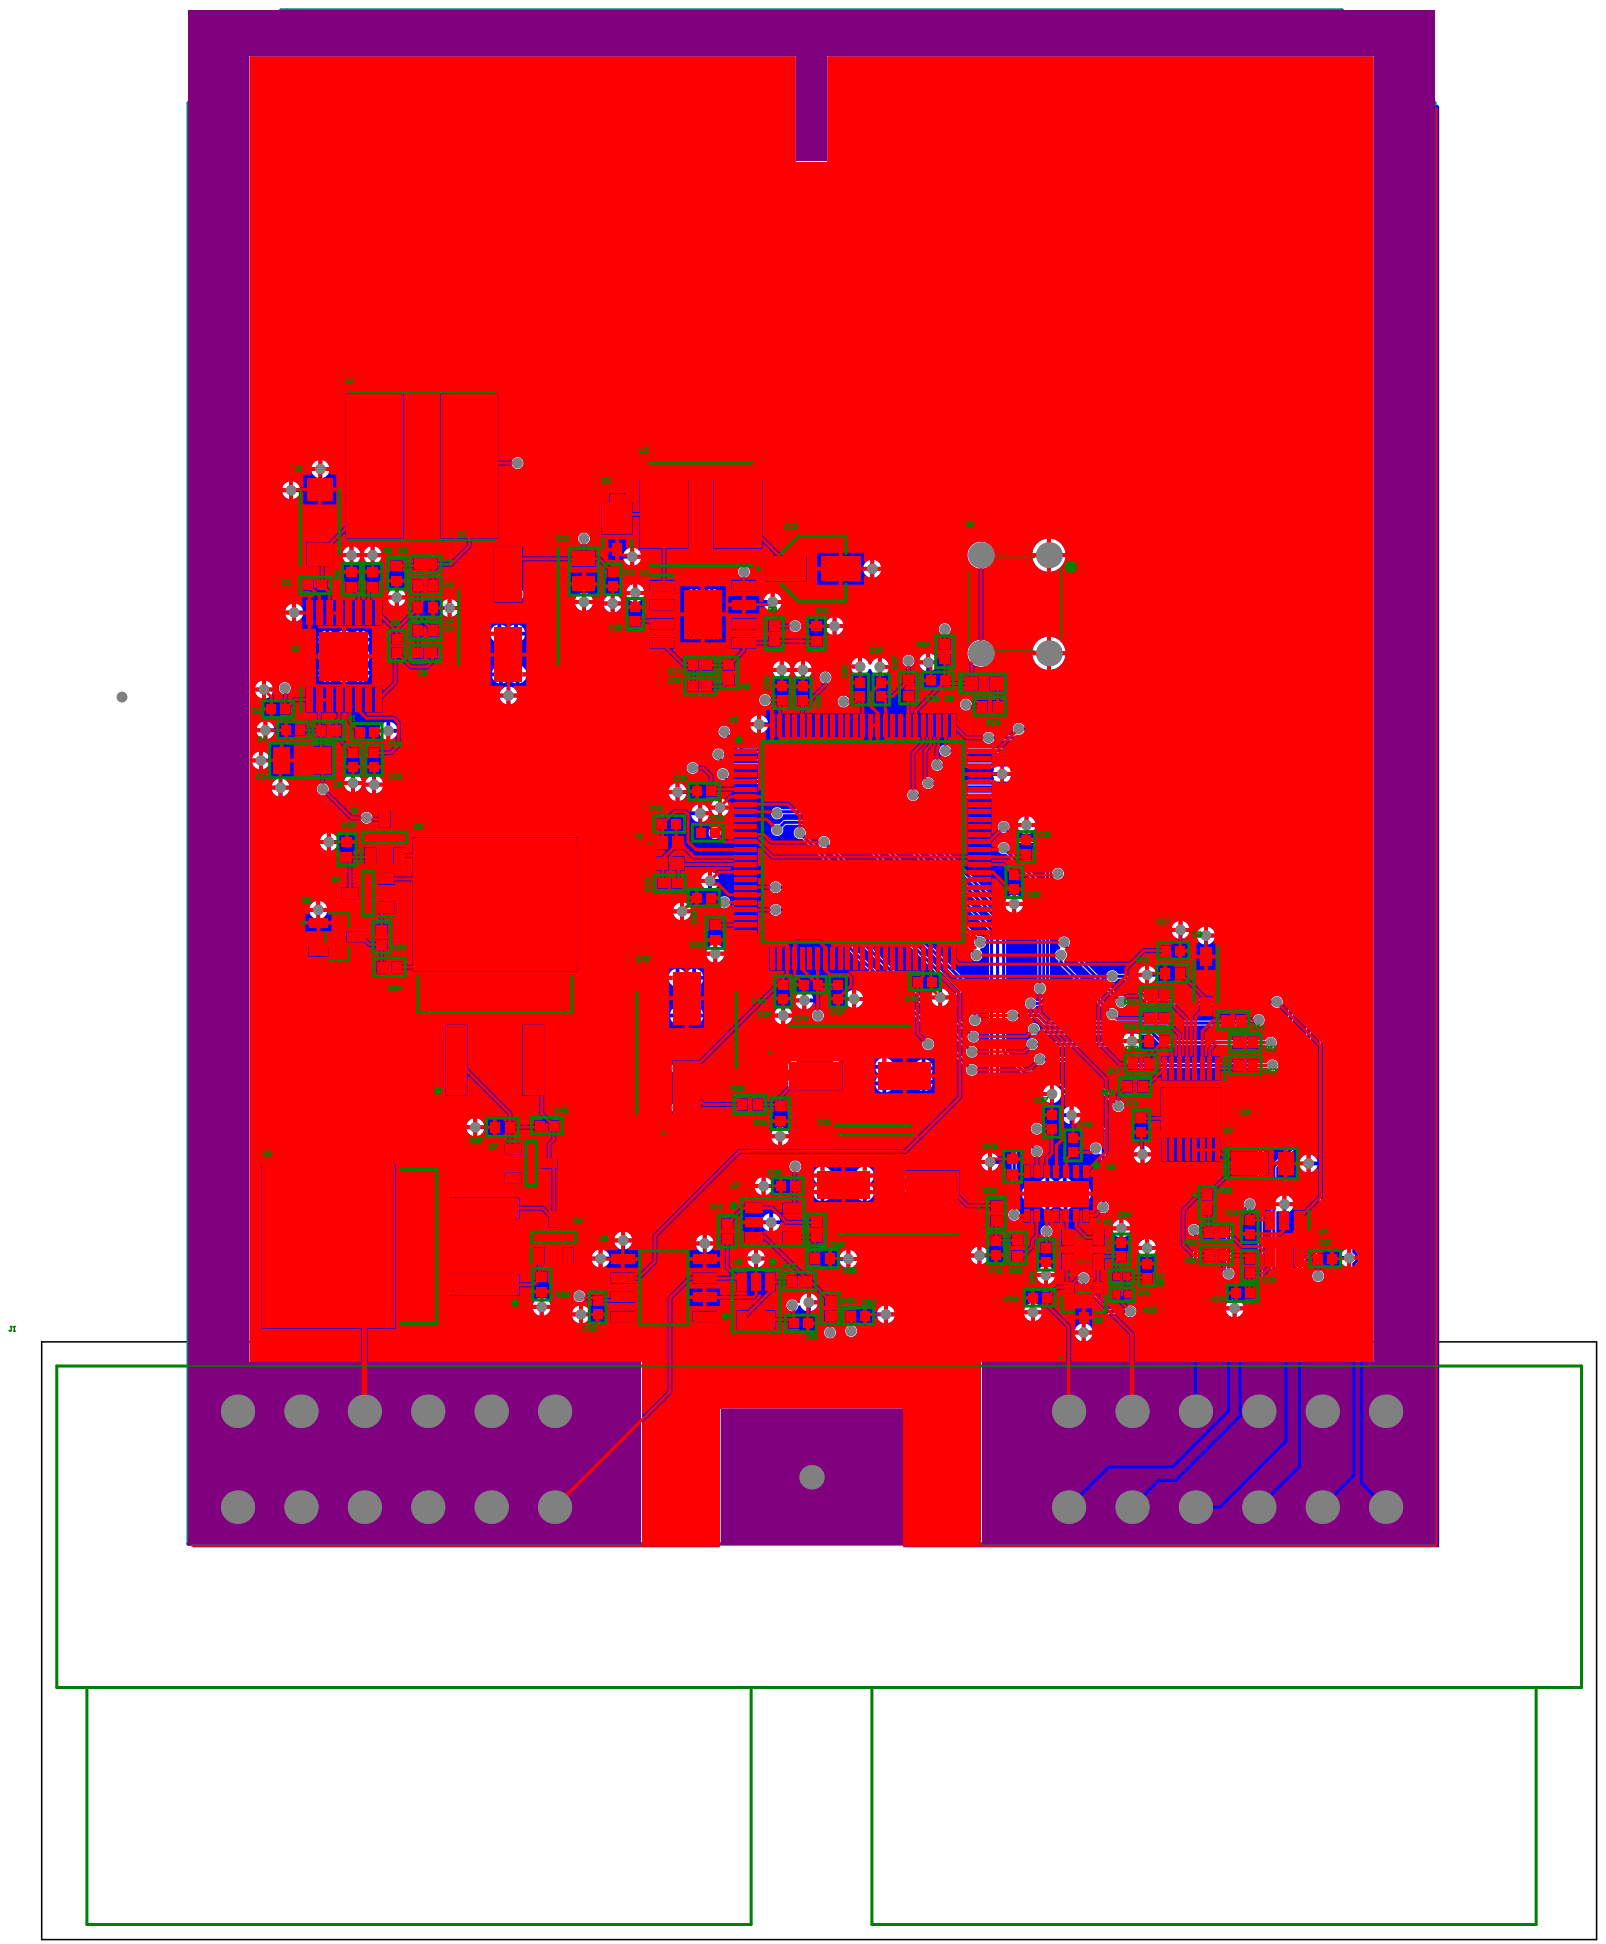
[picture p21: page 1]

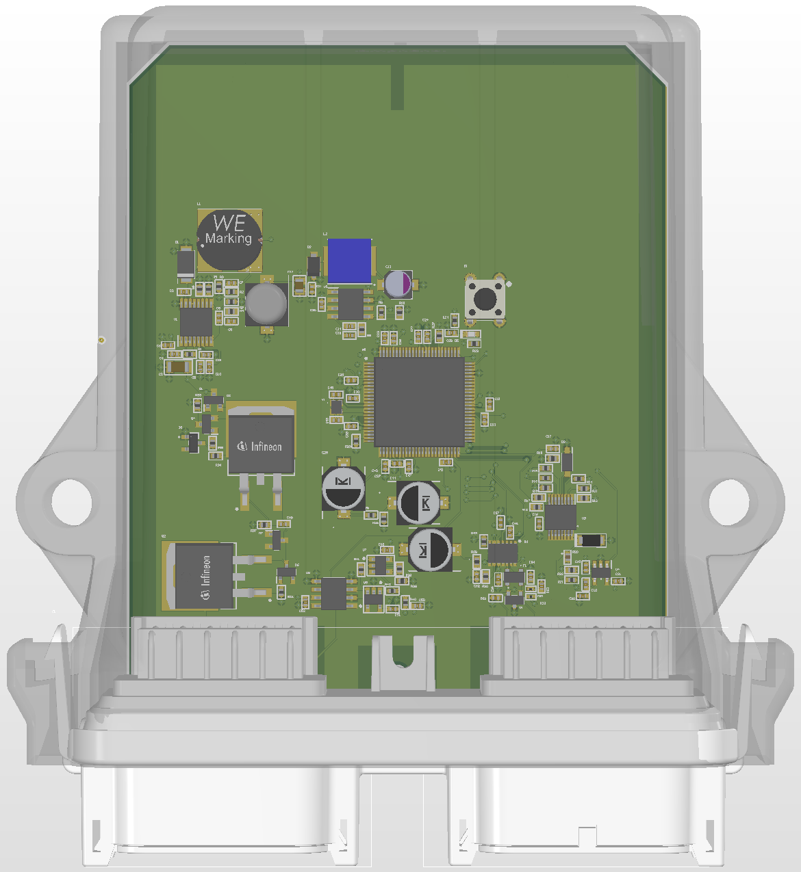
[picture p22: page 2]

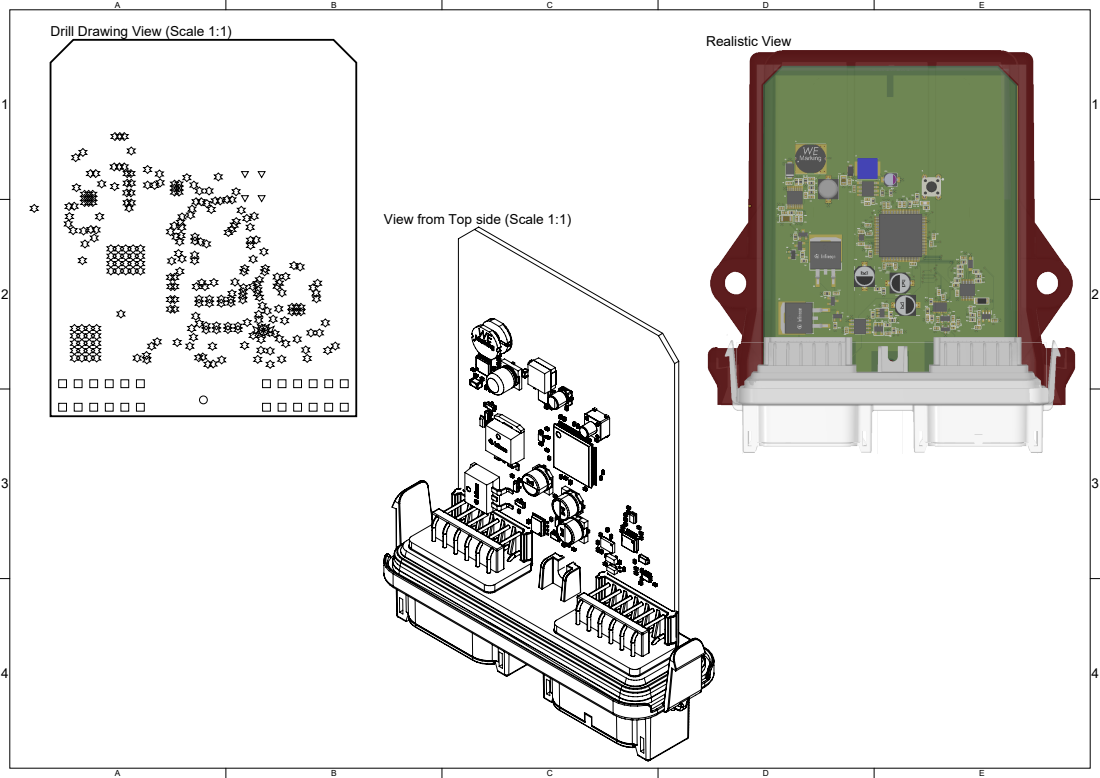
[picture p23: page 3]

Drill Drawing View (Scale 1:1)

View from Top side (Scale 1:1)

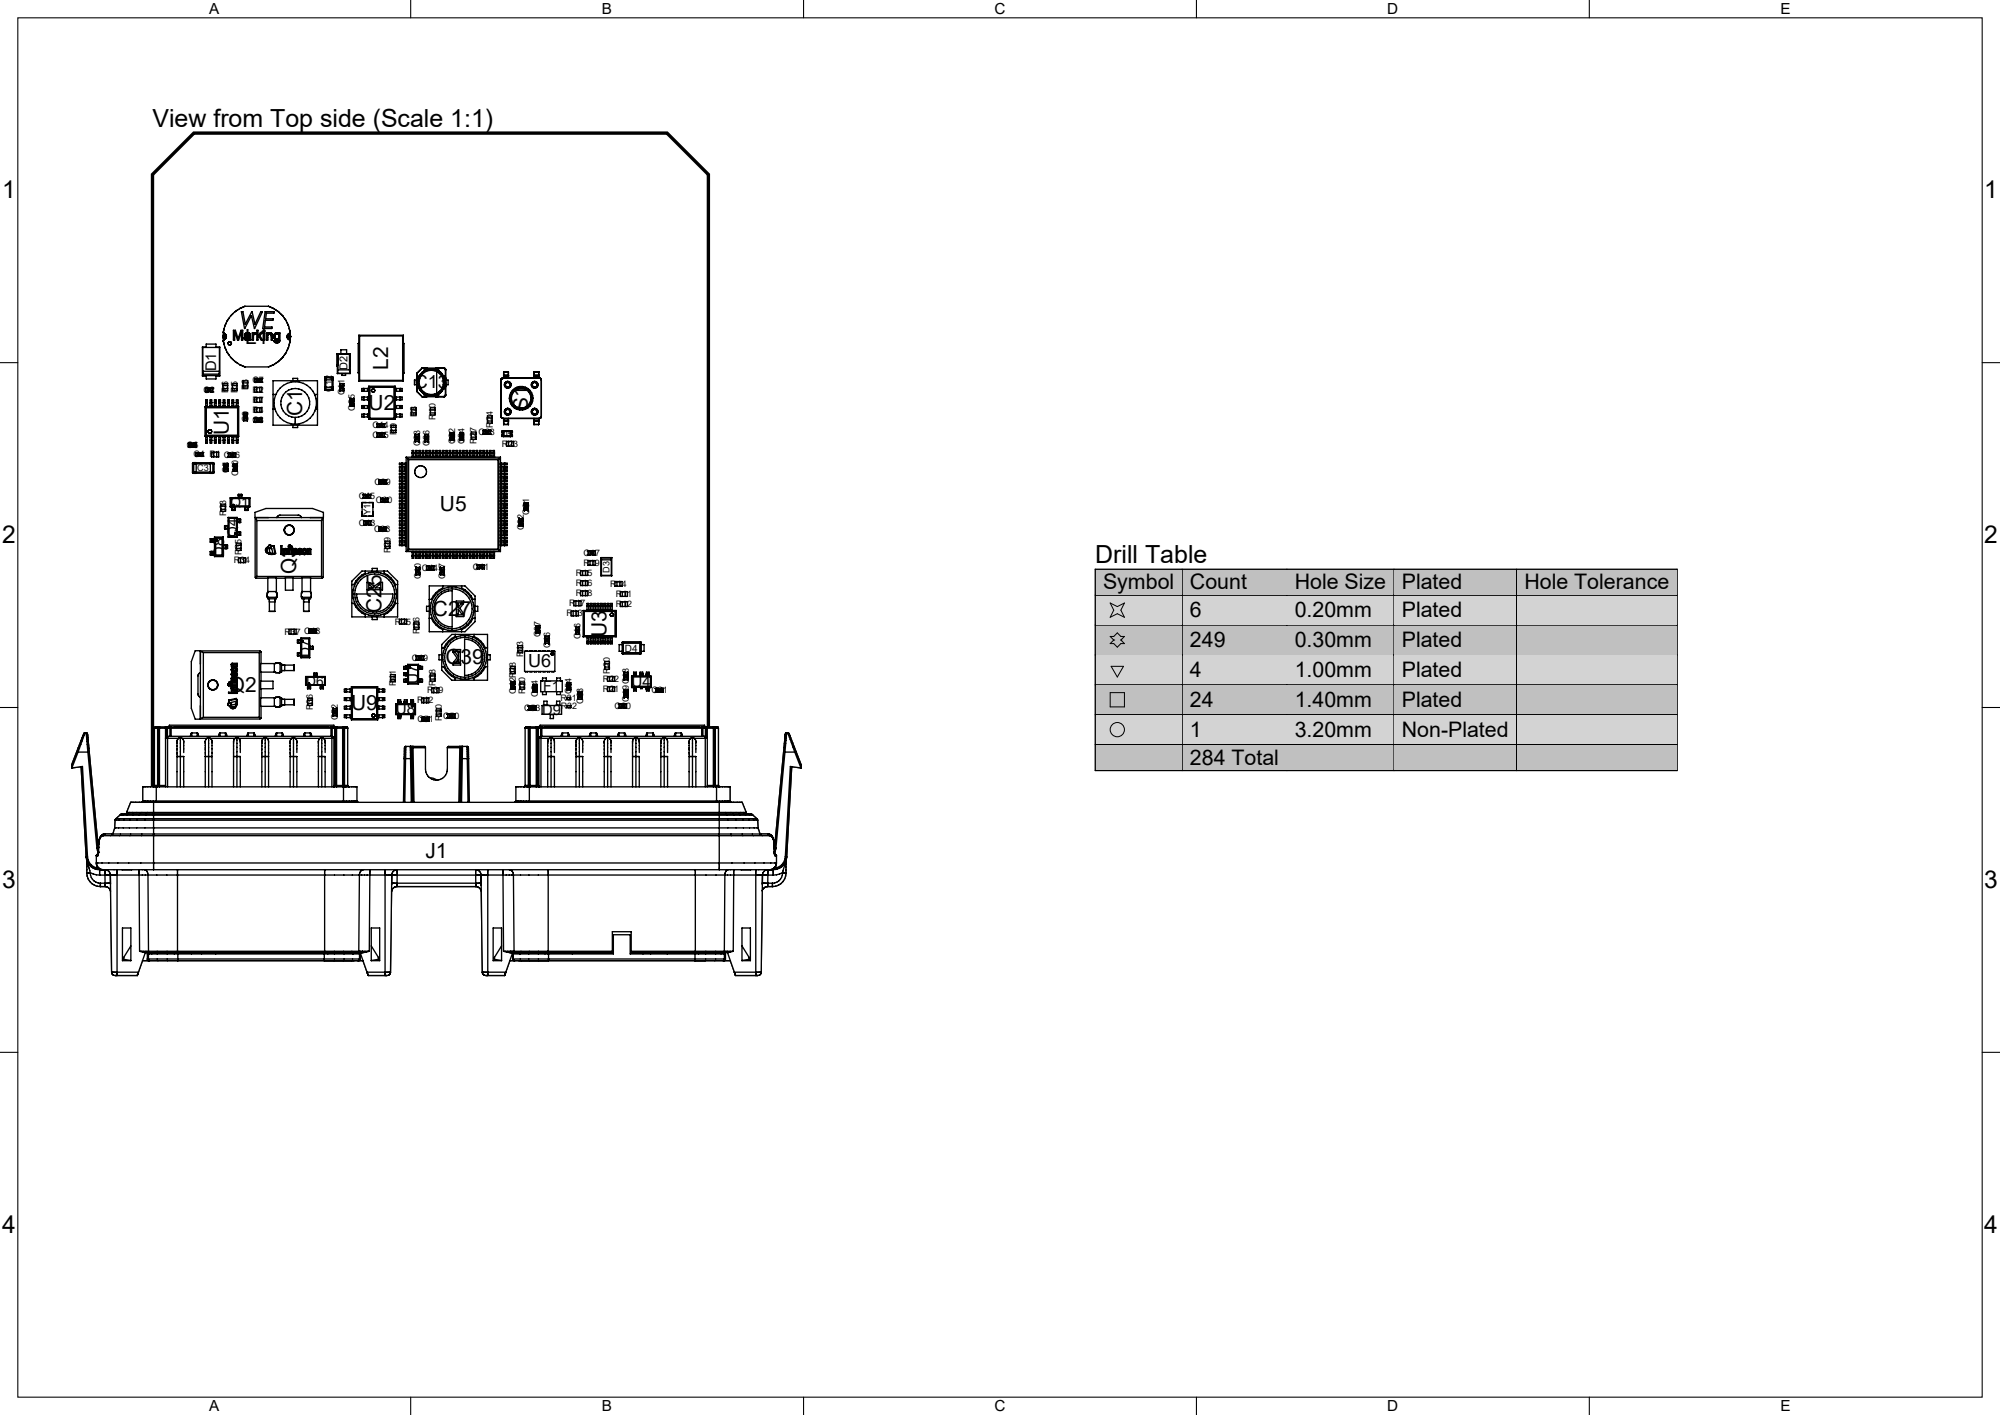
[picture p24: page 4]

View from Top side (Scale 1:1)

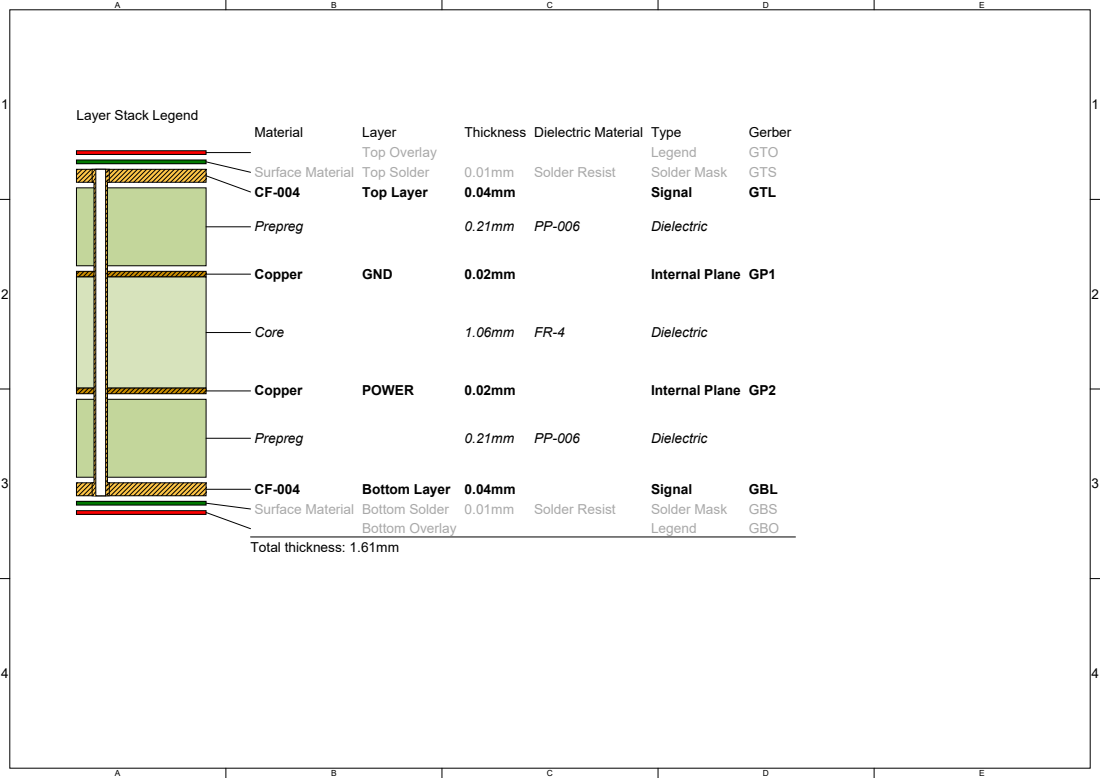
[picture p25: page 5]
