raulhorgos/Automotive-electronics-system-project/Altium Files/Project Outputs for PCB_Project/Task 1 Horgos Raul George.PDF

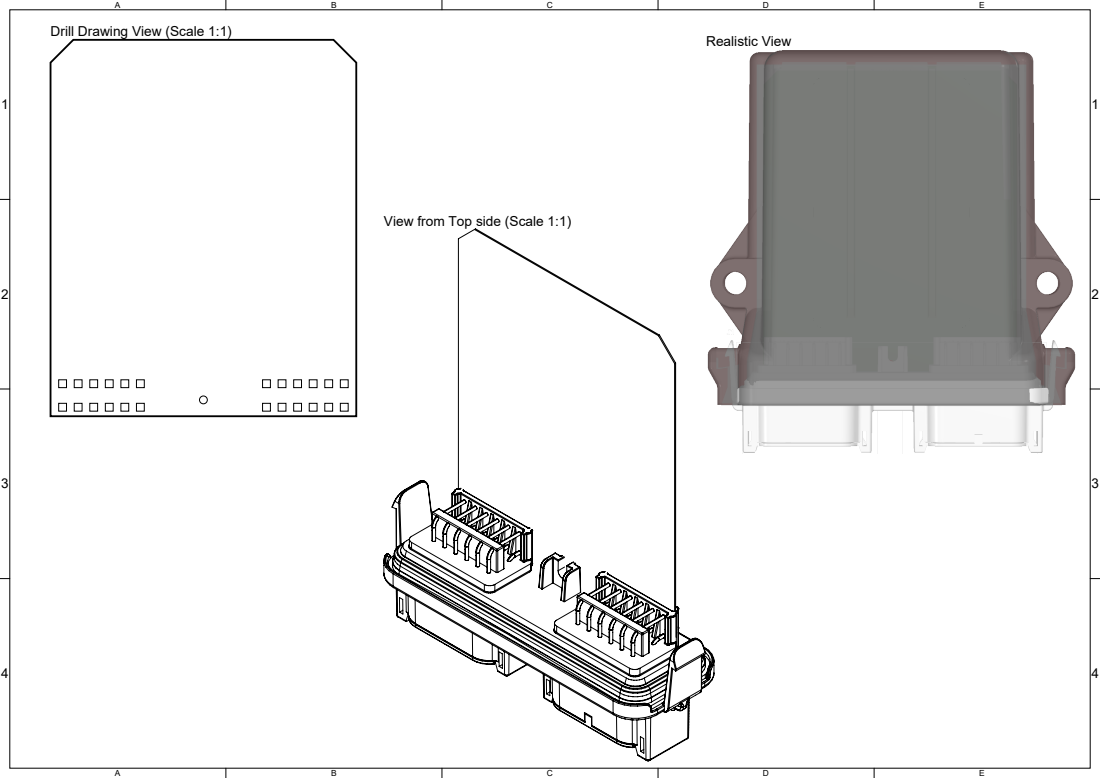
[picture p26: page 1]

Drill Drawing View (Scale 1:1)

View from Top side (Scale 1:1)

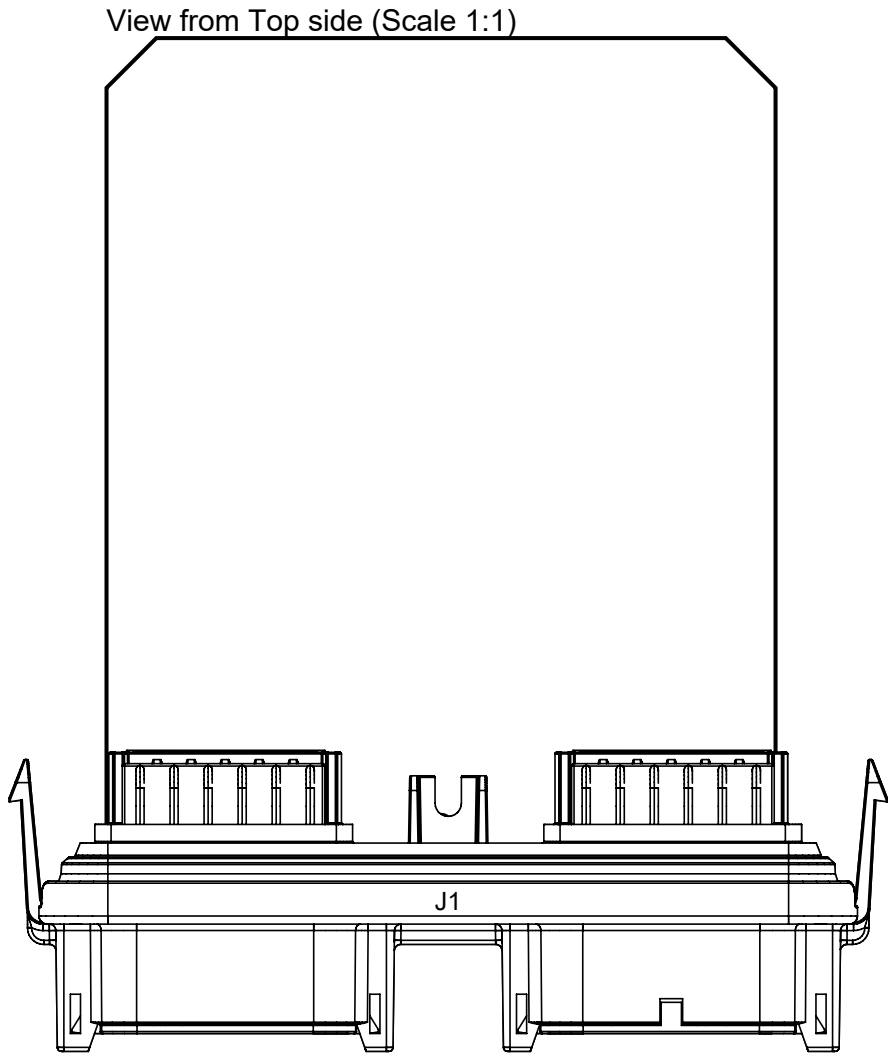
[picture p27: page 2]

View from Top side (Scale 1:1)

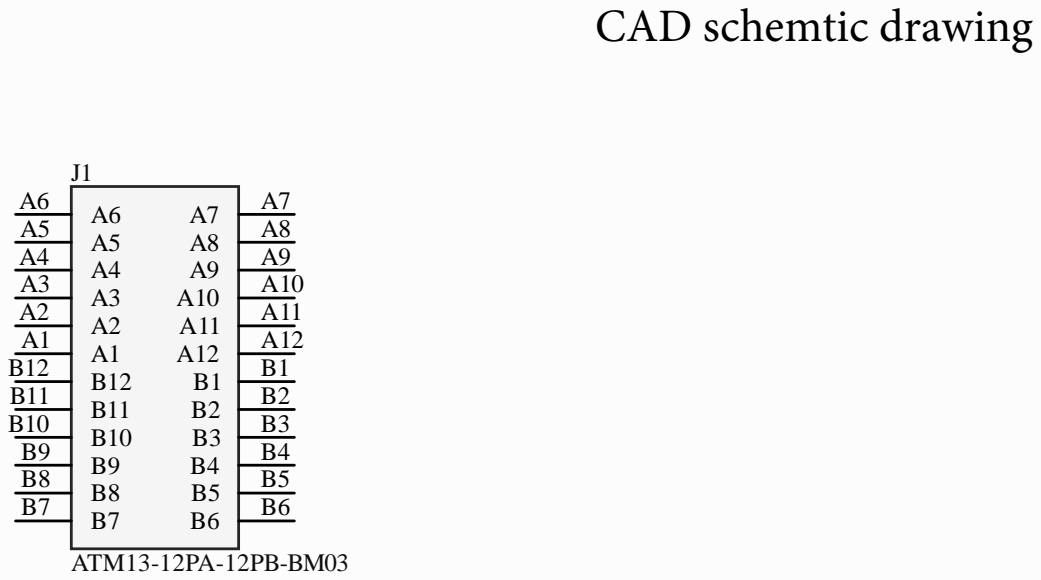
[picture p28: page 3]

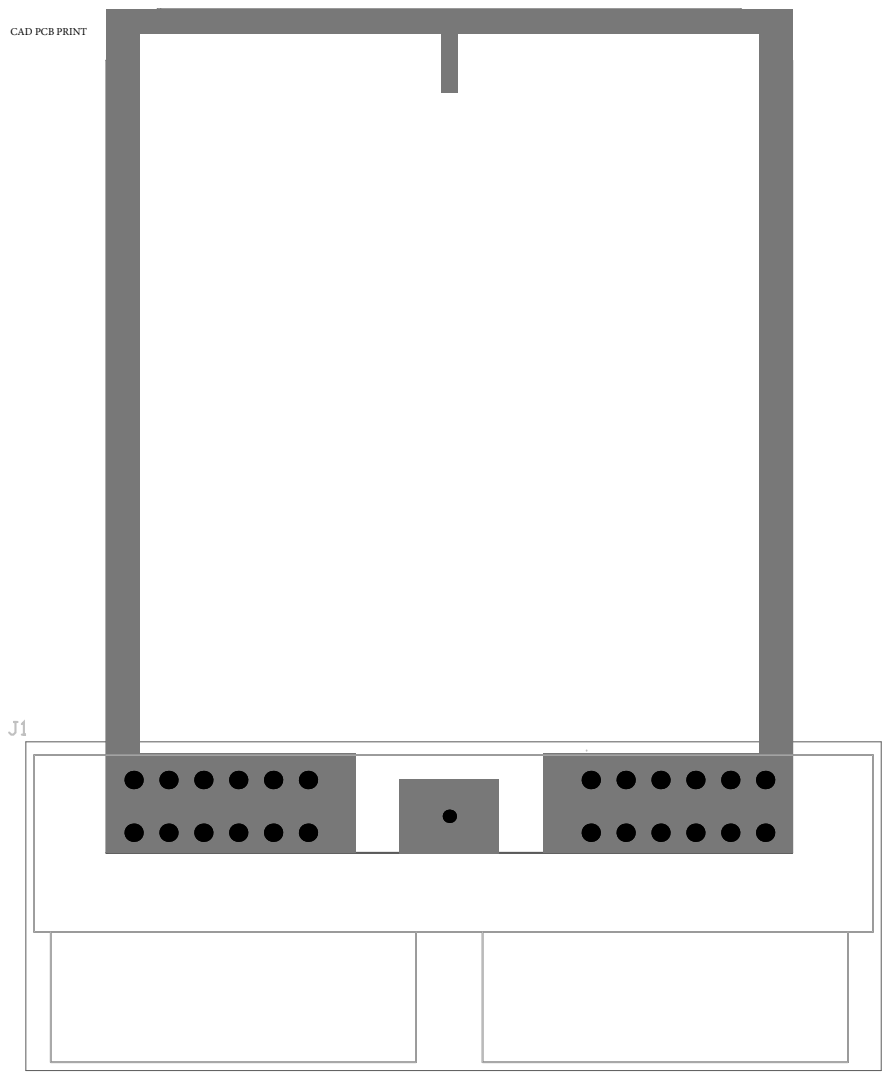
[picture p29: page 4]
