raulhorgos/Automotive-electronics-system-project/Altium Files/Project Outputs for PCB_Project/Schematic.PDF

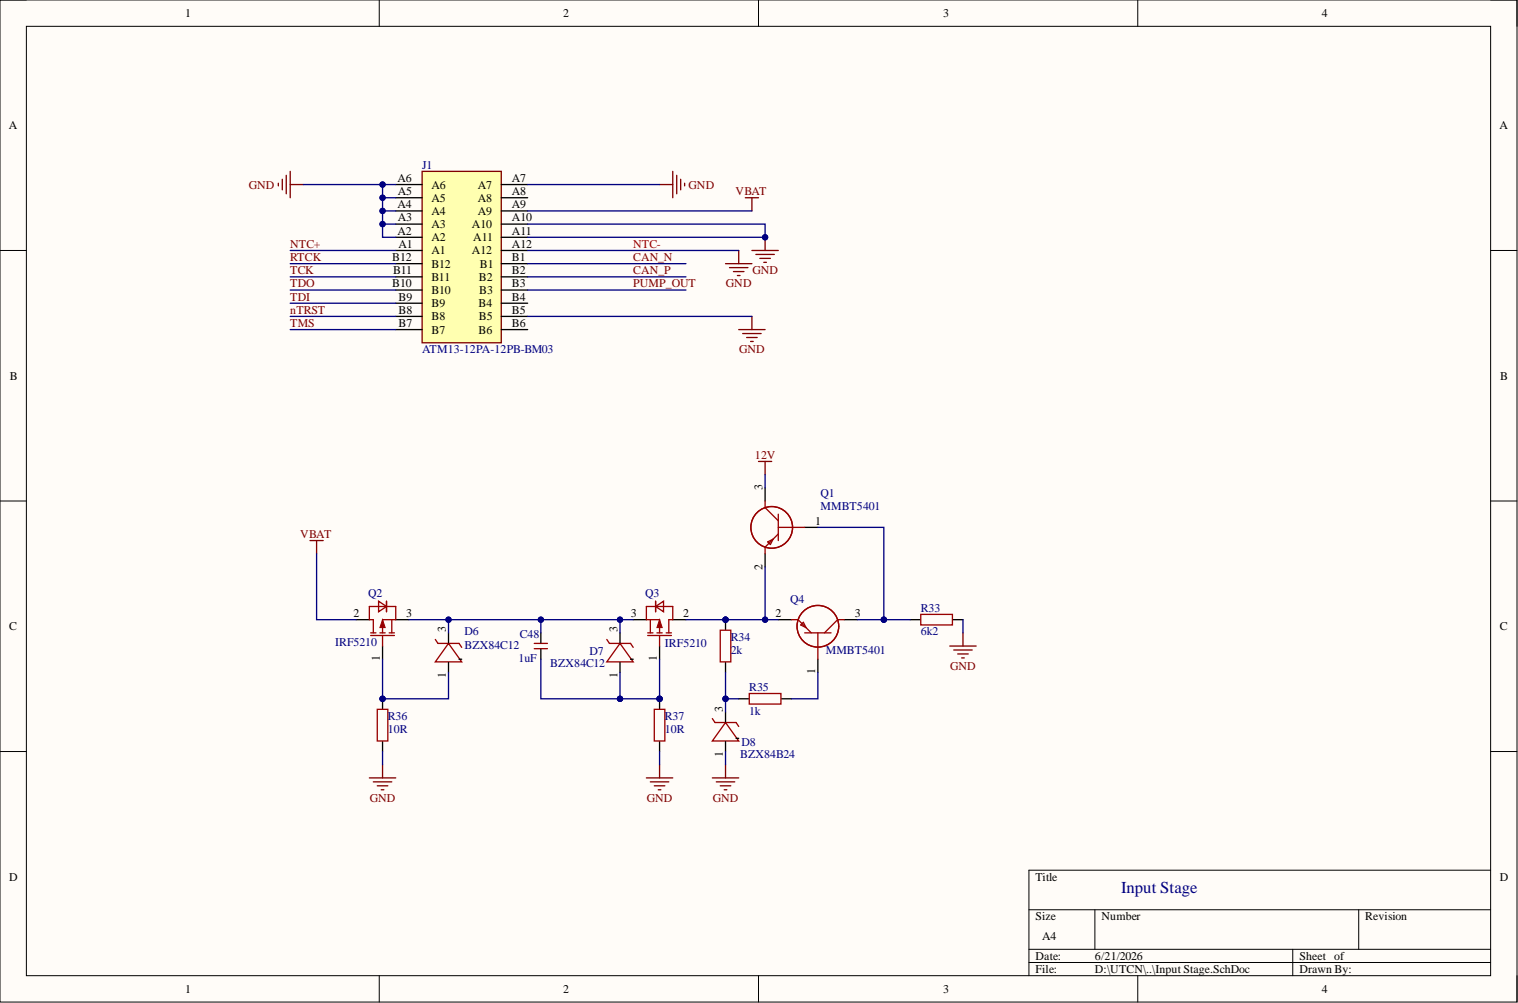
[picture p30: page 1]

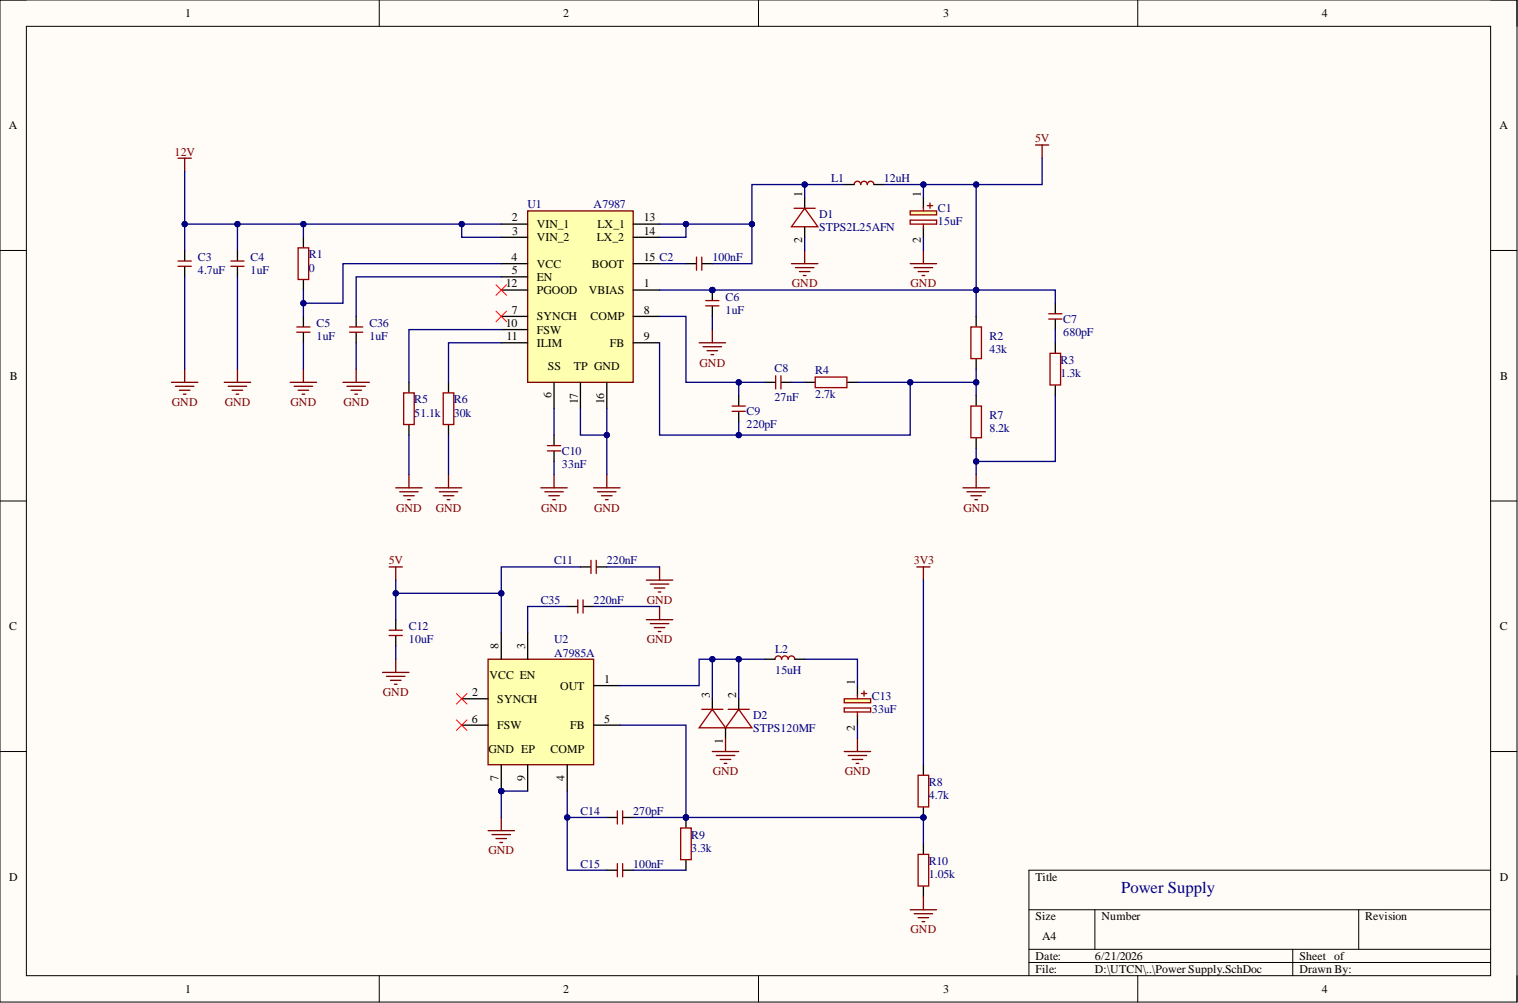
[picture p31: page 2]

VIN_2 3 | 100nF

VCC 4 | C2
EN 5
PGOOD 12

ILIM 11 FSW 10

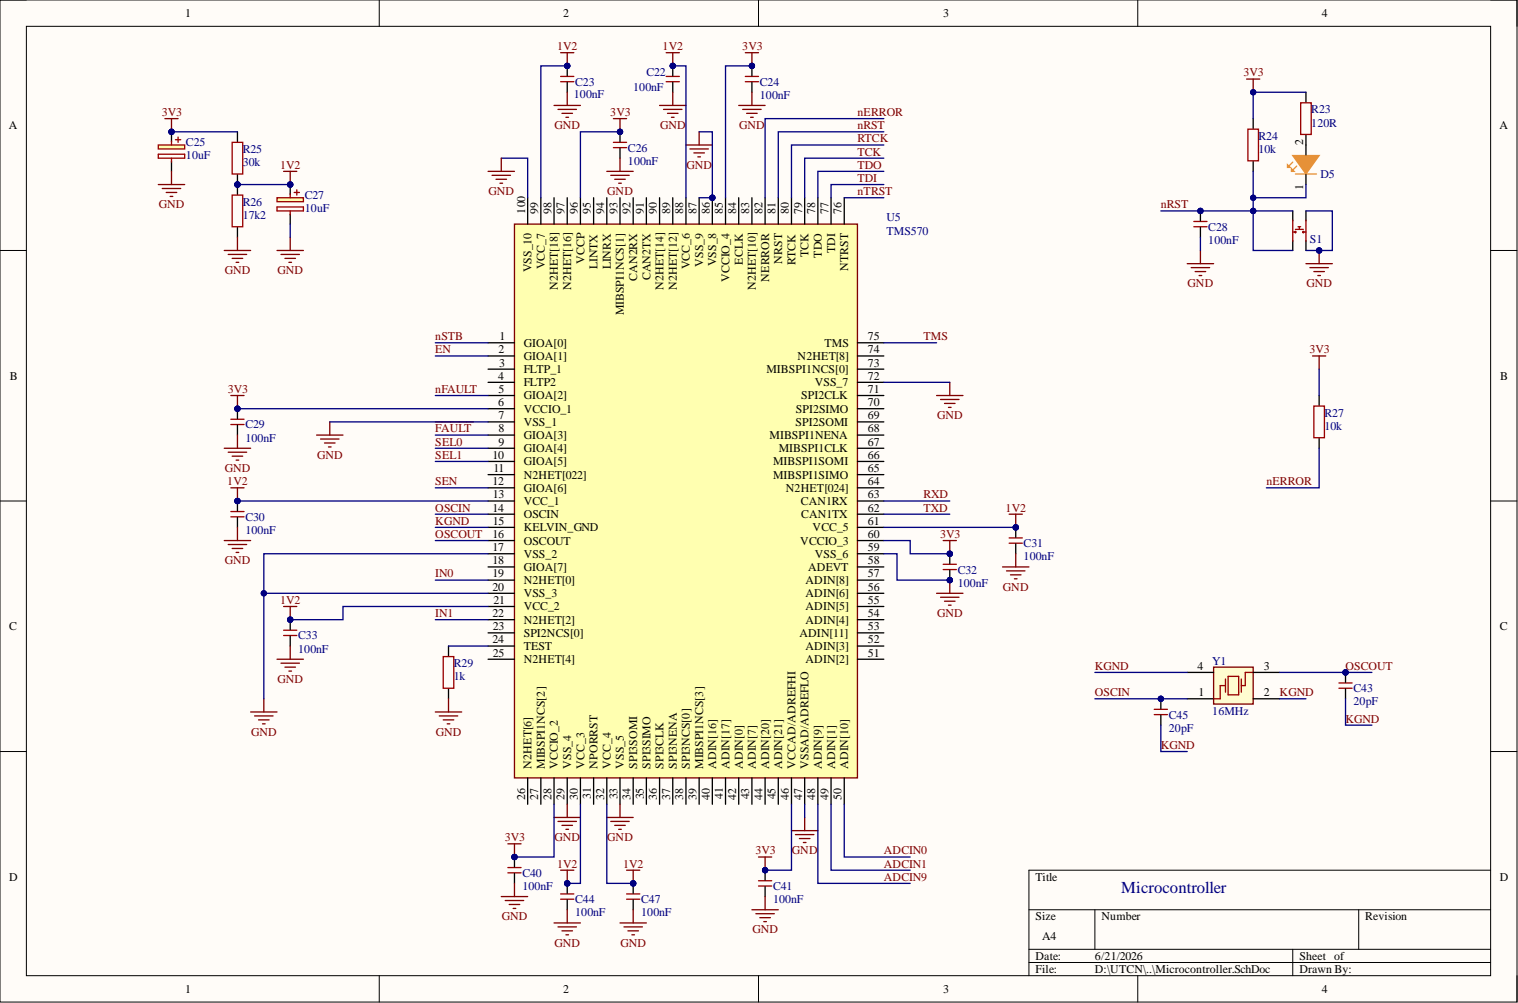
[picture p32: page 3]


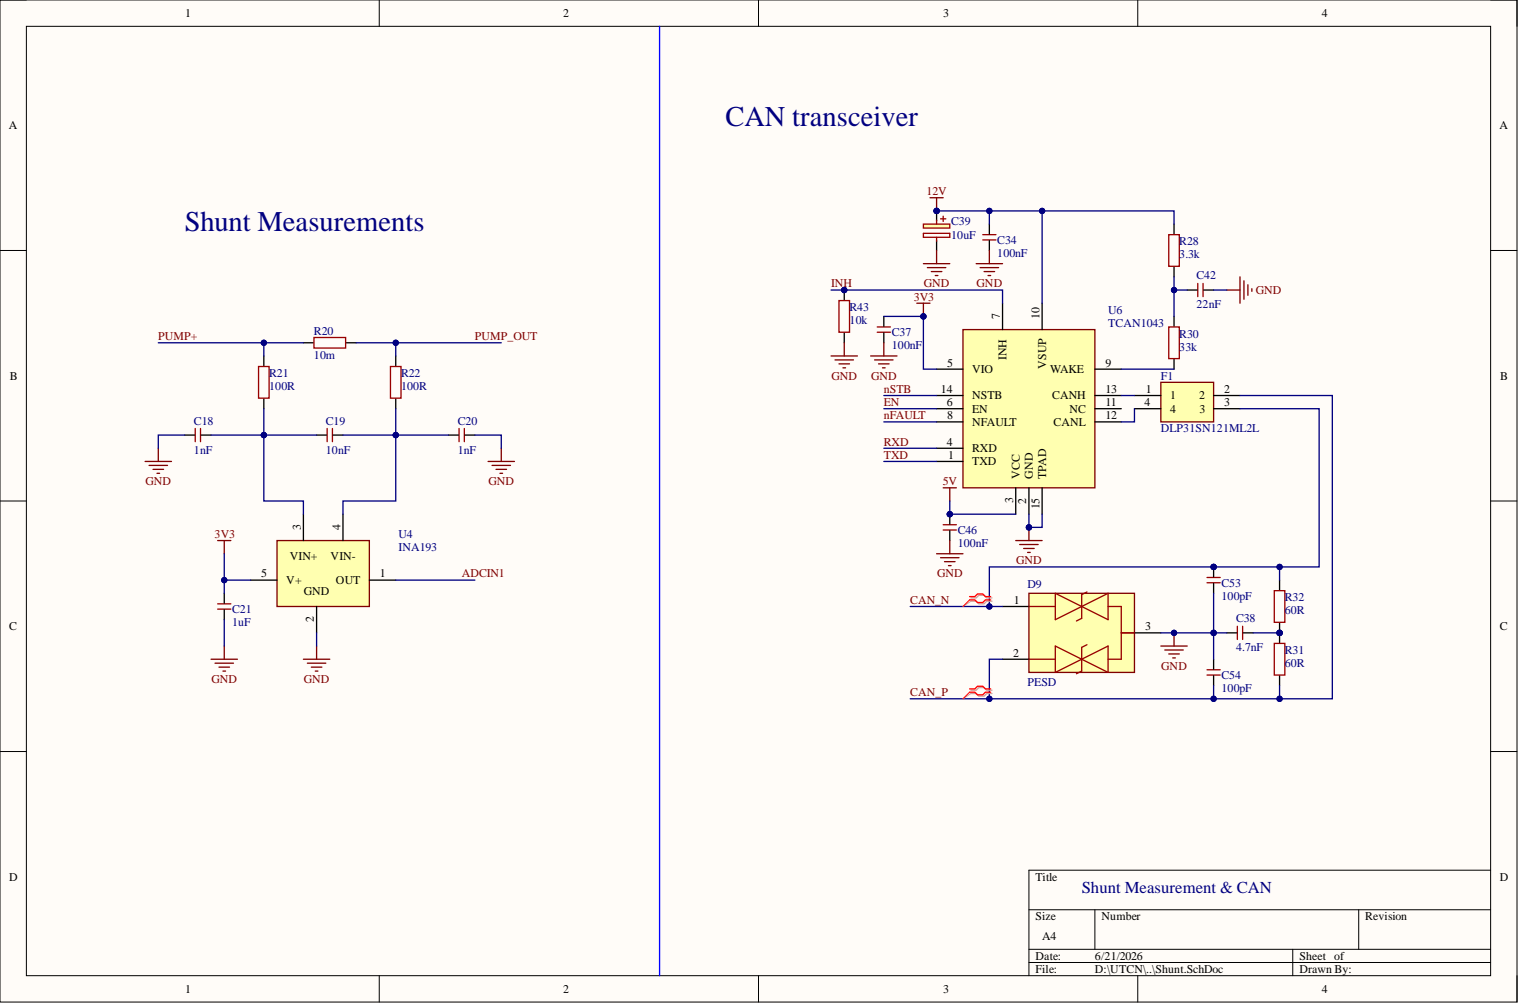
[picture p33: page 5]

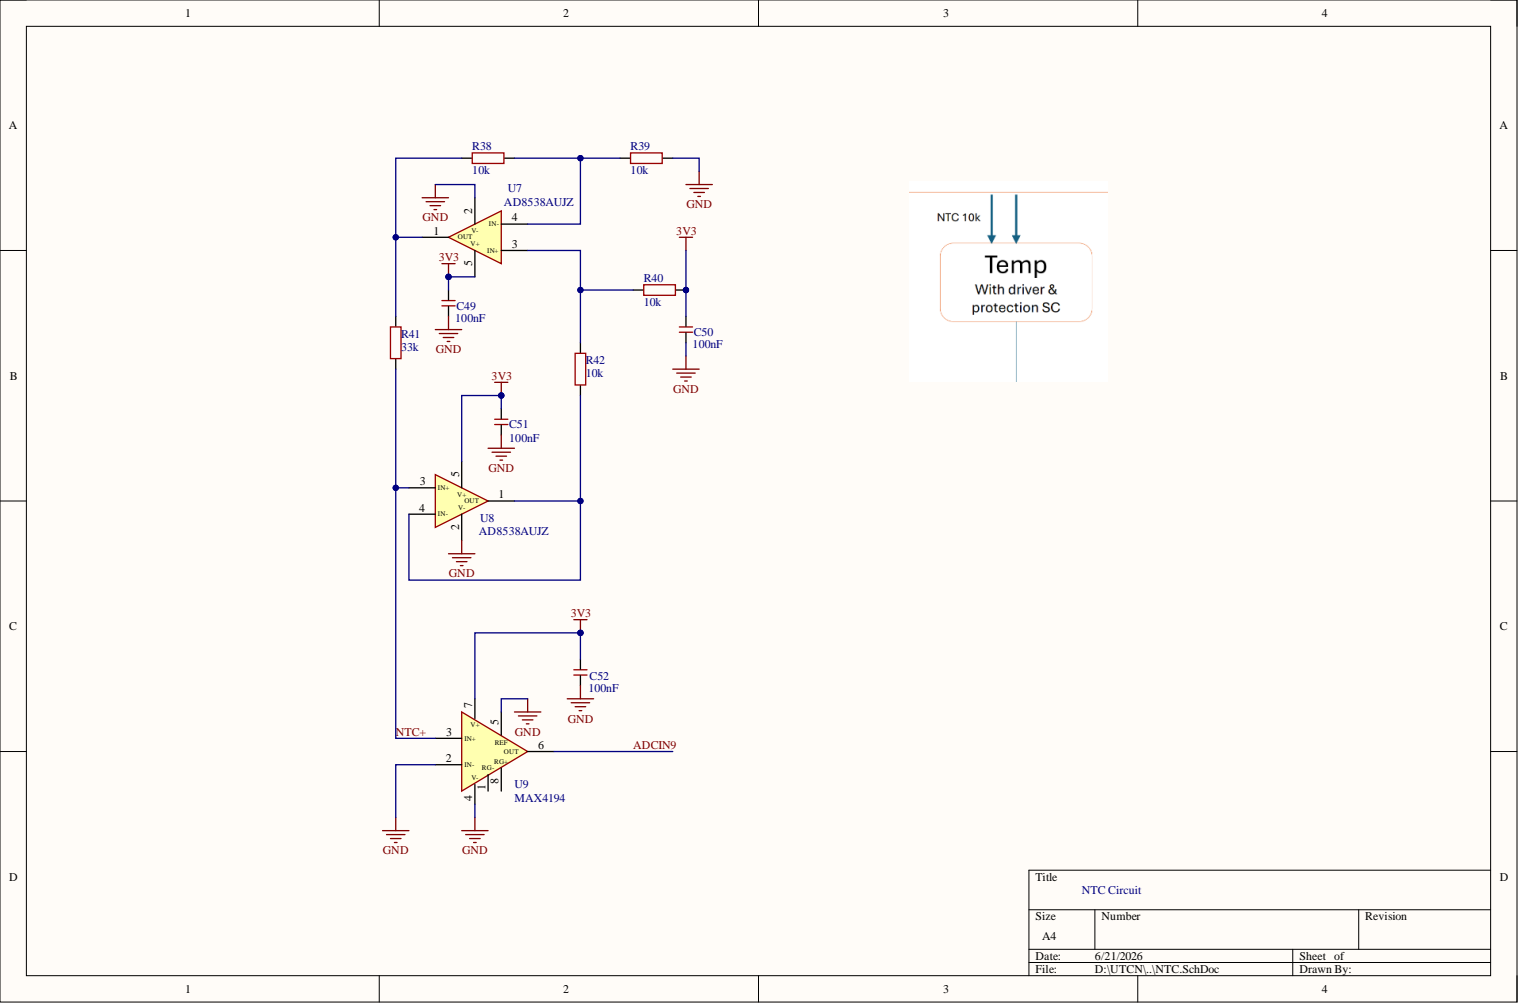
[picture p34: page 6]
