raulhorgos/Automotive-electronics-system-project/Altium Files/Project Outputs for PCB_Project/Drill drawing.PDF

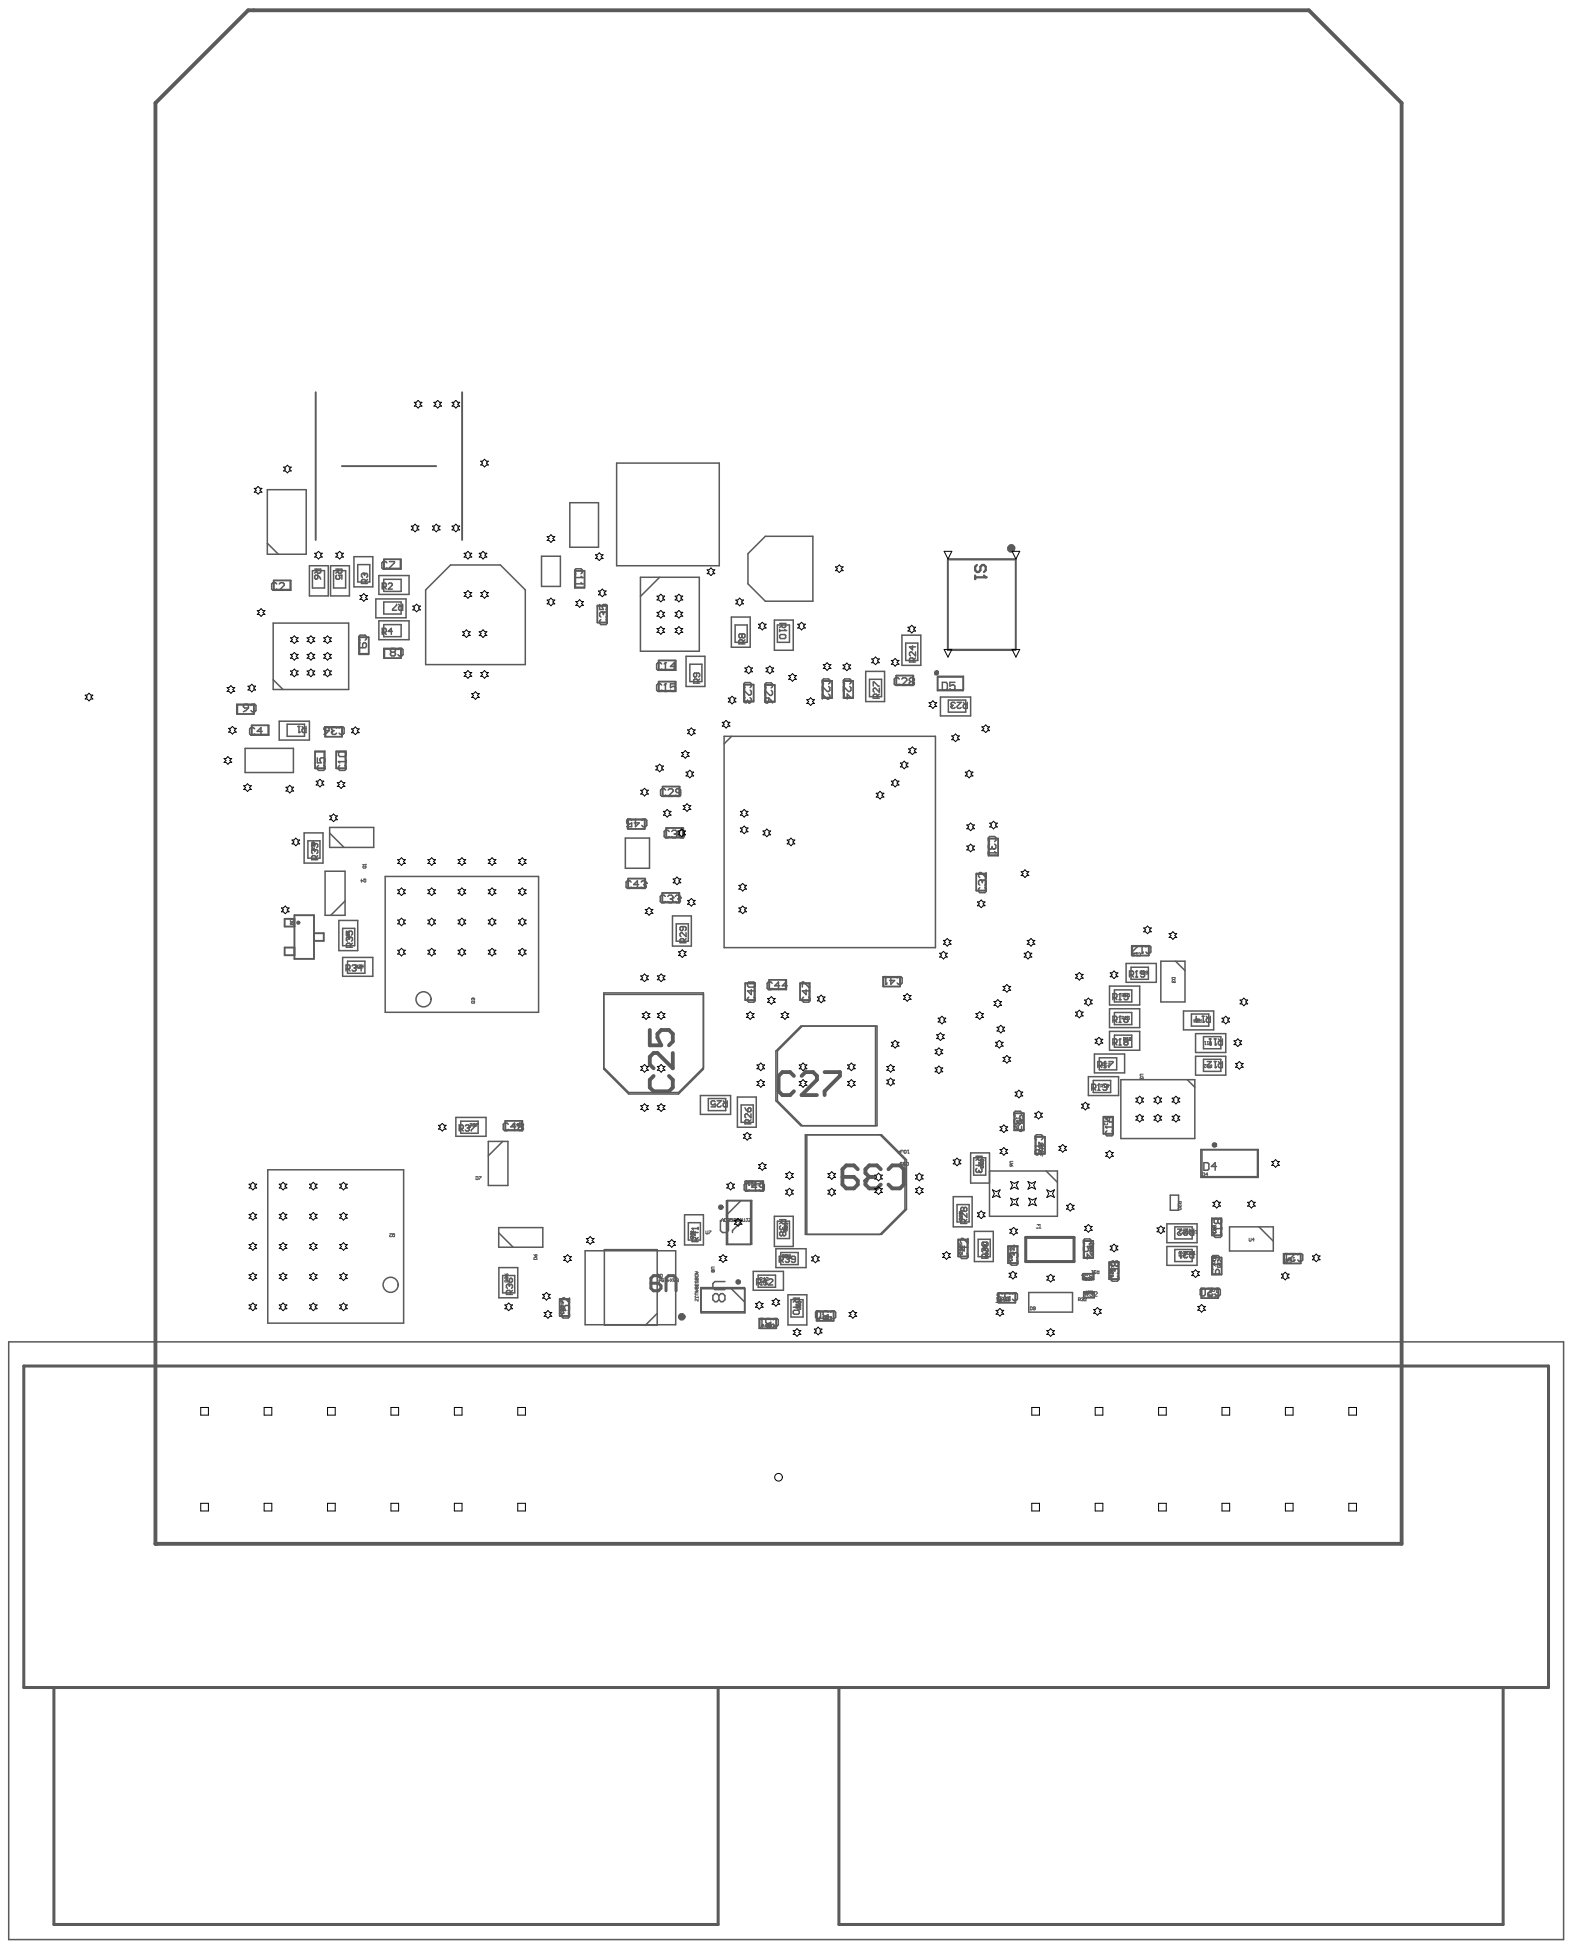
[picture p35: page 1]

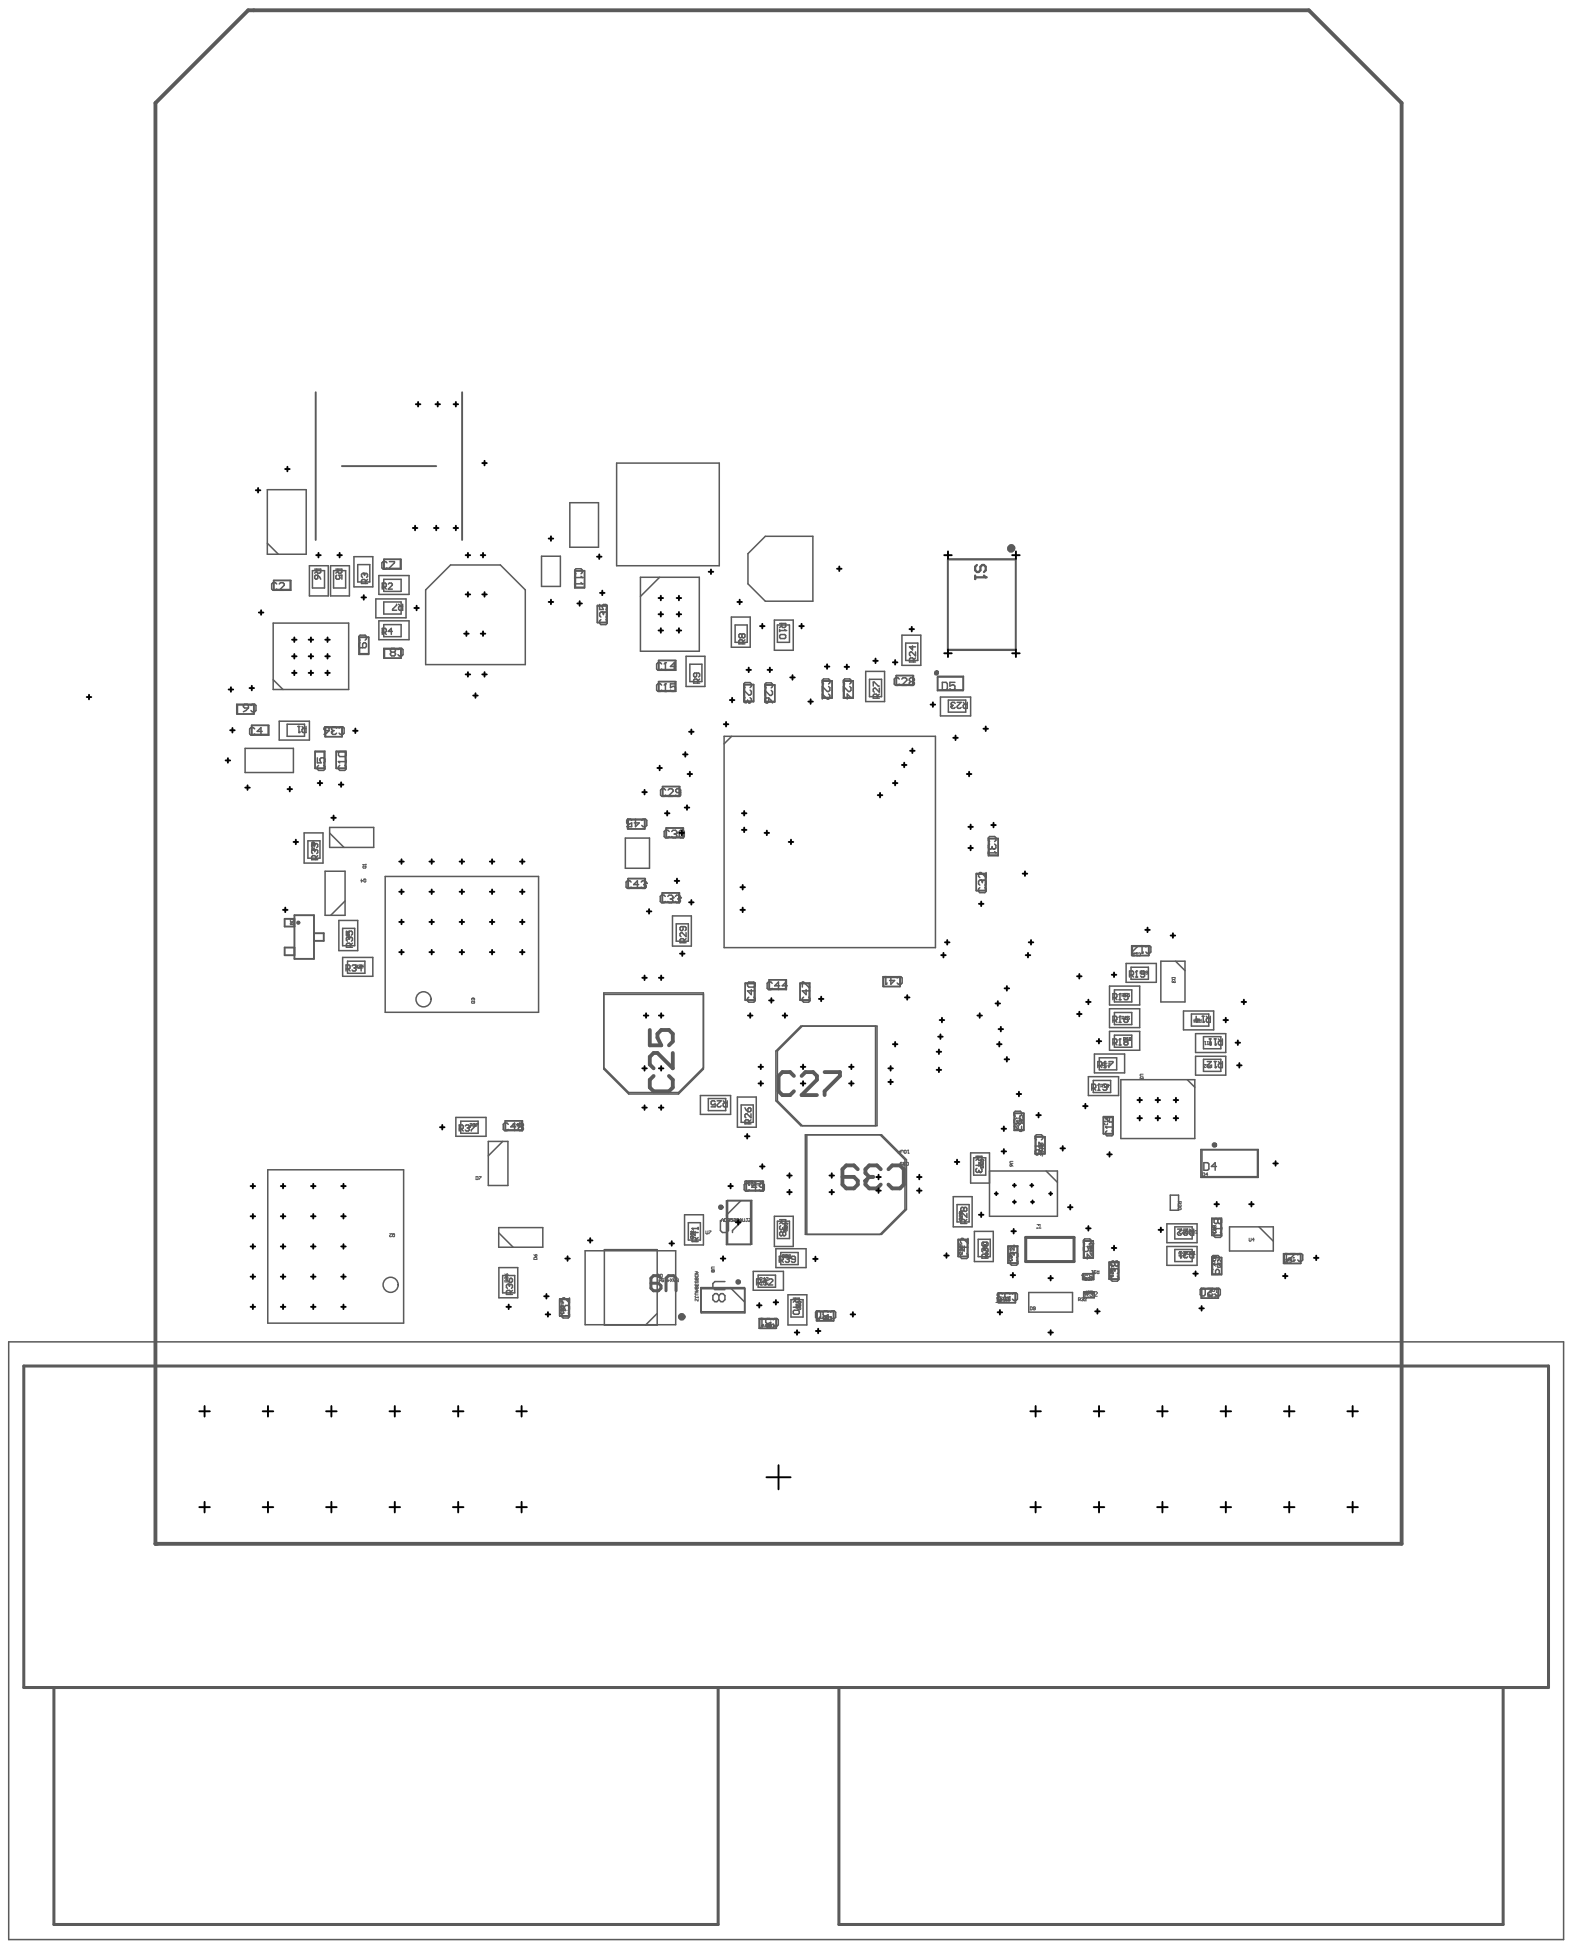
[picture p36: page 2]
