raulhorgos/Automotive-electronics-system-project/LTSpice simulations/Protection.asc

C1: cap; 1µ
D1: zener; BZX84C12L
D2: zener; BZX84C12L
D3: zener; BZX84B24VLY
M1: pmos; HAT1072H
M2: pmos; HAT1072H
Q1: pnp; 2N5401
Q2: pnp; 2N5401
R1: res; 10
R2: res; 1k
R3: res; 10
R4: res; 2k
R5: res; 1k
R6: res; 6.2k
R7: res; 50
V1: voltage; PULSE(12 -12 0 0.1n 0.1n 1m 5m)
Named nets: 0, in, out
.model HAT1072H VDMOS(pchan Rg=3 Rd=1.4m Rs=1.1m Vto=-2 Kp=103 lambda=.03 Cgdmax=4.2n Cgdmin=.5n Cgs=4.3n Cjo=3n Is=310p Rb=1.8m mfg=Renesas Vds=-30 Ron=3.6m Qg=155n)
.tran 0 600m 0
Reverse polarity protection
Inrush current protection
Overvoltage protection (clamp at 24V)
Load
