raulhorgos/Automotive-electronics-system-project/LTSpice simulations/Reverse polarity.asc

C1: cap; 220n; Rser=2
C2: cap; 100µ
D1: zener; EDZV10B
D2: zener; EDZV10B
M3: pmos; HAT1072H
M4: pmos; HAT1072H
R1: res; 15
R2: res; 10
R3: res; 10
U1: ISO7637-2
Named nets: 0
.tran 0 250 0 1m
