raulhorgos/Automotive-electronics-system-project/(list of files, drawings)

Other design files:
Altium Files/Input Stage.SchDoc
Altium Files/Microcontroller.SchDoc
Altium Files/NTC.SchDoc
Altium Files/PCB1.PcbDoc
Altium Files/PCB_Project.PrjPcb
Altium Files/PcbLib1.PcbLib
Altium Files/Power Supply.SchDoc
Altium Files/Pump Driver.SchDoc
Altium Files/Schlib1.SchLib
Altium Files/Shunt.SchDoc
